BILLyTheLiTTle/RCCar_Engineering/README.md

# RCCar_Engineering
Everything for my experimental R/C car apart from source code.

The source code for the Android controller could be found here (https://github.com/BILLyTheLiTTle/RCController) and for the server on R/C car is here (https://github.com/BILLyTheLiTTle/RCCar).
