BILLyTheLiTTle/RCCar_Engineering/Parts/Mechanics/Mods/Standoffs/README.txt

== 10mm height standoff ==
- Rpi PowerRack

== 5mm height standoff ==
- Buck converters
- Perfboard / Veroboards
