BILLyTheLiTTle/RCCar_Engineering/Parts/Mechanics/Transmission System/3rd party design/Links.txt

The BTS7960 Housing was found here (https://www.thingiverse.com/thing:2589207/files) by b2vn.
