BILLyTheLiTTle/RCCar_Engineering/Designs/Mechanics/Differential/Description.pdf

## SOFTWARE DIFFERENTIAL FORMULAS

### Table of Contents

Introduction
During the implementation of my R/C Car I decided to design the formulas for the software differential. The R/C Car will have 4 motors, so the software differential is the only way. Apart from that, I believe that mechanical differentials:
- Cannot be improved further
- Cannot be smaller in size with the stiffness which a car needs
- Cannot be lighter (probably the can but they could be much more expensive)
- Cannot be eco-friendly (need fluids, power loss due to their moving parts and extra axles)
- Cannot take less space in the cabin (sometimes the place where you rest your hand is a camouflage for the axle that goes to the rear).

On the other side, electric motors just started to exist in automotive industry and probably they have more secrets to reveal! How about changing your car’s differential from open to locked in a single update? Now that I have your attention, we can continue!

Formulas
Symbols
Before starting the calculation, we have to say that we know the following:
- WL (wheel length distance, kingpin to kingpin),
- WW (wheel width distance, kingpin to kingpin),
- WR (wheel radius),
- TAwr & FAwr (outer front wheel turning angle),
- TAwf & FAwf (inner front wheel turning angle),
- Af (car turning angle).

The inner wheel formula should be equal to the real turning angle in order to achieve concentric circles.

The formulas for the Ackerman steering according to this (http://datagenetics.com/blog/december12016/index.html) (based on simple trigonometry of course, interior-exterior corresponding angles and triangle angles equality to 180 o
), are:
- | TAwf = ARif | (a)
- TAwr = ARof (b)
- | A’f = ARf | (c)

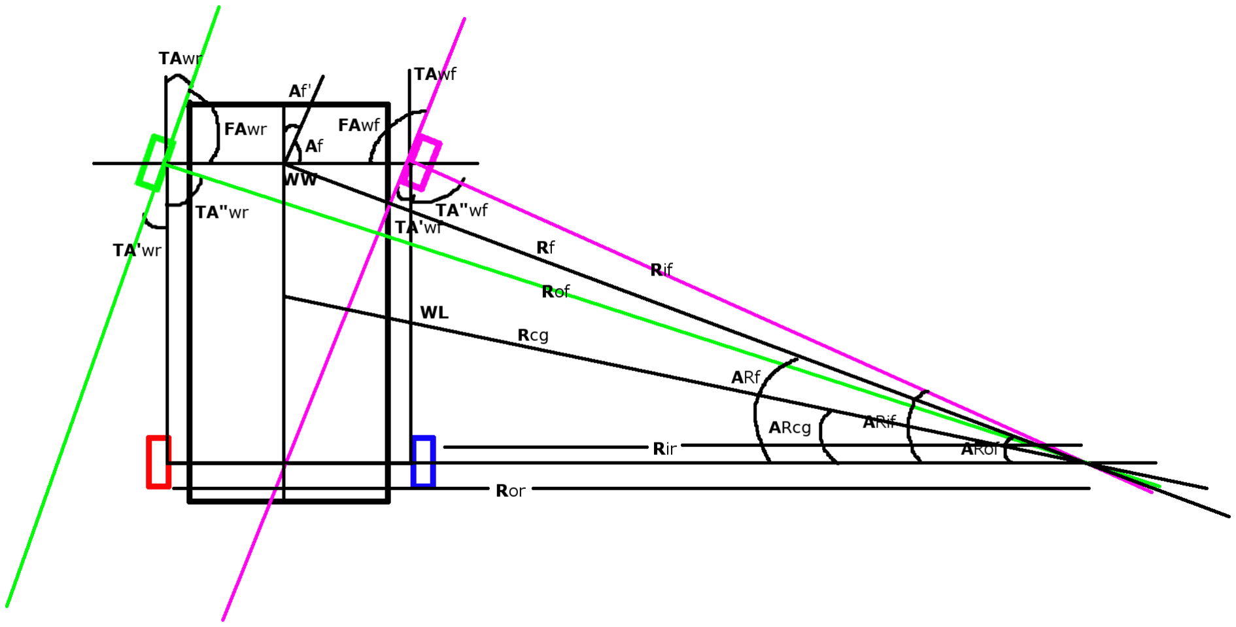
[picture p1: figure]

Prerequisite Formulas
Analyzing the angle equality, we have:

TA”wf + TA’wf = 90o => (TA’wf and TAwf angles are equal)

TA”wf + TAwf = 90o =>

TA”wf = 90 – TAwf (d)

And

TA’wr + TA”wr = 90o => (TA’wr and TAwr angles are equal)

TAwr + TA”wr = 90o =>

TA”wr = 90o – TAwr (e)

We could use inverse tangent because we know the angle:

TA”wf = tan⁻¹
(Rir / WL) => (due to (d))

(90 – TAwf) = tan⁻¹
(Rir / WL) (f)

And

TA”wr = tan⁻¹
(Ror / WL) => (due to (e))

(90o – TAwr) = tan⁻¹
(Ror / WL) (g)

Rear Inner Wheel
According to the formula (f) we have:

(90 – TAwf) = tan⁻¹
(Rir / WL) =>

(90 – TAwf) = arctan(Rir / WL) =>

tan(90 – TAwf) = tan(arctan(Rir / WL)) =>

tan(90o – TAwf) = Rir / WL =>

tan(90o – TAwf) * WL = Rir

Therefore, the rear inner wheel is moving into a circle with radius:

Rir = tan(90o – TAwf) * WL (h)

Rear Outer Wheel
Without further ado, we have:

Ror = WW + Rir

Therefore, the rear outer wheel is moving into a circle with radius:

Ror = WW + Rir (i)

Front Outer Wheel
Using the steering angles, we have:

sin(ARof) = WL / Rof =>

Rof = (WL / sin(ARof) ) => (due to (b))

Rof = (WL / sin(TAwr) )

Therefore, the front outer wheel is moving into a circle with radius:

Rof = (WL / sin(TAwr) ) (j)

Front Inner Wheel
Using the steering angles, we have:

sin(ARif) = WL / Rif =>

Rif = ( WL / sin(ARif) ) => (due to (a))

Rif = ( WL / sin(TAwf) )

Therefore, the front inner wheel is moving into a circle with radius:

Rif = ( WL / sin(TAwf) ) (k)

Center of the car
We are going to use also data about the car as an object. In true Ackerman we have every wheel moving in concentric circles, but in parallel and reverse steering the front wheels are moving in different circles. So, we must find out the circle in which the center of the car is moving.

Every point on the car is moving in concentric circles. This mean that the center of the front axle, the center of the car and the center of the rear axle are moving into concentric circles.

By having a device measuring the angle of the car (Af) we could calculate the Af angle.

Let’s define R’ir that it is the radius for the center of the circle to the inner rear wheel.

In true Ackerman steering we have Rir’ = Rir (l) because wheels and car are moving into concentric circles, but at the other two options (parallel, reverse) the car could be moving in non-concentric circle with the wheels. Even the wheels themselves are probably moving in non-concentric circles. Then we have:

tan(ARf) = WL / (R’ir + WW/2) => (due to (c))

tan(A’f) = WL / (R’ir + WW/2) =>

R’ir = (WL / tan(A’f)) – WW/2 (l’)

As said before, every point on the car is moving in concentric circles, so the chassis is not able to steer like the front wheels, so the whole car chassis is moving in concentric circles. This means that the straight lines Rf, Rcg are starting from the car chassis and they are ending in the same point (center of concentric circles).

Applying Pythagorean theorem and due to above explanation, we have:

(Rcg)

2 = (R’ir + WW/2)² + (WL/2)²

Continuing further from Pythagorean equation, for true Ackerman steering:

(Rcg)

2 = ( Rir’ + WW/2 )² + (WL / 2)² => (due to (l))

(Rcg)

2 = ( Rir + WW/2 )² + (WL / 2)²

Continuing further from Pythagorean equation, for parallel and reverse steering:

(Rcg)

2 = ( Rir’ + WW/2 )² + (WL / 2)² => (due to (l’))

Rcg = SQRT ( ( (WL / tan(Af

’

) ) - WW/2 + WW/2 )² + (WL / 2)² ) =>

Rcg = SQRT ( ( (WL / tan(Af

’

) ) )² + (WL / 2)²
)

The formulas should be:

True Ackerman Steering formula: Rcg = SQRT ((Rir + WW/2)² + (WL / 2)² ) (m)

Parallel, Reverse Steering Formula Rcg = SQRT ( ( (WL / tan(Af

’

) ) )² + (WL / 2)²
) (m’)

Wheel Rotations
The front outer wheel will travel the longest distance of all four wheels. Our calculations will be based on this wheel because if the driver is in 100% throttle, we cannot make a motor to work at more than 100%. So, the we apply the throttle to the outer front wheel (instead of a motor in simple Evs, or combustion engine on fossil fuel cars).

On the other side, if the outer wheel is not moving, we could apply 0 power, or negative (in a future implementation…probably!).

From paper “Electronic Differential System for an Electric Vehicle with In-Wheel Motor” (https://ieeexplore.ieee.org/document/7394567) we have the following formulas for Estimated Rotations (ER):

ERof = Wof = V x Rof / (Rcg x WR) (n)

ERif = Wif = V x Rif / (Rcg x WR) (o)

ERor = Wor = V x Ror / (Rcg x WR) (p)

ERir = Wir = V x Rir / (Rcg x WR) (q)

for open differential. For locked differential just apply the same rotation (not PWM value) value to each wheel. For in-between values just pick some values in-between!

For example:

- Open Differential -> Outer front wheel will have max rotations and the others according to the previous calculations
- Semi-open Differential Front -> Outer front wheel will have max rotations and the opposing wheel will have an in-between (from open to locked) value
- Semi-open Differential Rear -> Outer rear wheel will have max rotations (as max as possible in relation with the outer front wheel) and the opposing wheel will have an in-between (from open to locked) value
- Locked Differential -> Apply everywhere the same rotations

Predefined Table Example
We could use a predefined table in order to apply a close-to-correct PWM value faster. This is an example and should not be used as-is neither in the real world scenario nor in this document!
PWM value (% throttle value) | Rotations @ wheel (per second)
Front Left | Front Right | Rear Left | Rear Right
50 (19.61%) | 5 | 6 | 5 | 4
100 (39.21%) | 12 | 14 | 16 | 11
150 (58.82%) | 22 | 22 | 18 | 25
190 (74.51%) | 44 | 43 | 45 | 48
220 (86.27%) | 50 | 49 | 47 | 53
255 (100%) | 56 | 57 | 57 | 55

Vehicle Dynamics
Imagine that you could apply more throttle in the wheel which have more traction…

Later…

Use case (Ackerman scenario) For a car during a single right turn we have the input:

WL = 4m, WW = 1.5m, TAwr = 19o

, TAwf = 21.5o
, Af

’ = 20.15o
, 195/50R15,

throttle = 50%

and according to the previous equations we have:

(h) => Rir = tan(90 – TAwf) * WL = tan (90o – 21.5

o
) * 4 = 10.155m
(i) => Ror = WW + Rir = 1.5 + 10.154 = 11.655m
(j) => Rof = (WL / sin(TAwr) ) = 4 / sin(19o
) = 12.286m
(k) => Rif = ( WL / sin(TAwf) ) = 4 / sin(21.5o
) = 10.914m

And the rim calculations are:

RimRadius = (15 * 0.0254) / 2 = 0.1905m

TyreProfile = (0.195 * 0.5) = 0.0975m

WR = RimRadius + TyreProfile = 0.1905 + 0.0975 = 0.288m

Calculating the wheel rotations, we have:

For throttle = 50%, we have 127.5 of 255 PWM value, so we apply this PWM to outer front wheel and calculate its rotations by a speed sensor. Let’s say we have measured 17 rotations per second.

Parallel, reverse | Ackerman only
(m’) => Rcg = SQRT ( ( (WL / tan(Af ’ ) ) )² + (WL / 2)² ) => Rcg = SQRT ( ( (4 / tan(20.15) ) ) 2 + (4 / 2)² ) => 2 + 4) => Rcg = SQRT ( (10.901) Rcg = 11.083m | (m) => Rcg = SQRT ( (Rir + WW/2)² + (WL / 2)² ) => Rcg = SQRT( (10.155 + 0.75) 2 + (4/2) 2 ) => Rcg = 11.087m
(n) => Wof = V x Rof / Rcg x WR => 17 = V * 12.286 / 11.083 * 0.288 => 17 = V * 12.286 / 3.191904 => | (n) => Wof = V x Rof / Rcg x WR => 17 = V * 12.286 / 11.087 * 0.288 => 17 = V * 12.286 / 3.193056 =>

V = 17 * 3.191904 / 12.286 => V = 4.417 m/s | V = 17 * 3.193056 / 12.286 => V = 4.418 m/s
(o) => Wif = V x Rif / (Rcg x WR) => Wif = 4.417 * 10.914 / 11.083 * 0.288 => Wif = 15.103 rps | (o) => Wif = V x Rif / (Rcg x WR) => Wif = 4.418 * 10.914 / 11.087 * 0.288 => Wif = 15.101 rps
(p) => Wor = V x Ror / (Rcg x WR) => Wor = 4.417 * 11.655 / 11.083 * 0.288 => Wor = 16.12 rps | (p) => Wor = V x Ror / (Rcg x WR) => Wor = 4.418 * 11.655 / 11.087 * 0.288 => Wor = 16.126 rps
(q) => Wir = V x Rir / (Rcg x WR) => Wir = 4.417 * 10.155 / 11.083 * 0.288 => Wir = 14.053 rps | (q) => Wir = V x Rir / (Rcg x WR) => Wir = 4.418 * 10.155 / 11.087 * 0.288 => Wir = 14.051 rps
WFrontLeft = 17rps WFrontRight = 15.103 rps WrearLeft = 16.12 rps WrearRight = 14.053 rps | WFrontLeft = 17rps WFrontRight = 15.101 rps WrearLeft = 16.126 rps WrearRight = 14.051 rps

Flowchart
This flowchart is in early stage; so:
- It is not describing an algorithm in actual code,
- It needs an algorithm to calculate the PWM value for specified rotations,
- It has some restrictions (such as the differential settings could be applied when car is not moving).
- It cannot calculate ranges 29.5o

in a turning wheel is different from 29.6o .
This should not happen, at least in small speeds!
- It lacks hardware features (such us interruption) because I still don’t have a lot of experience on these. Programmed I/O is a good start, though!
- I have not decided if this software will work on a controller or on a OS using threads.

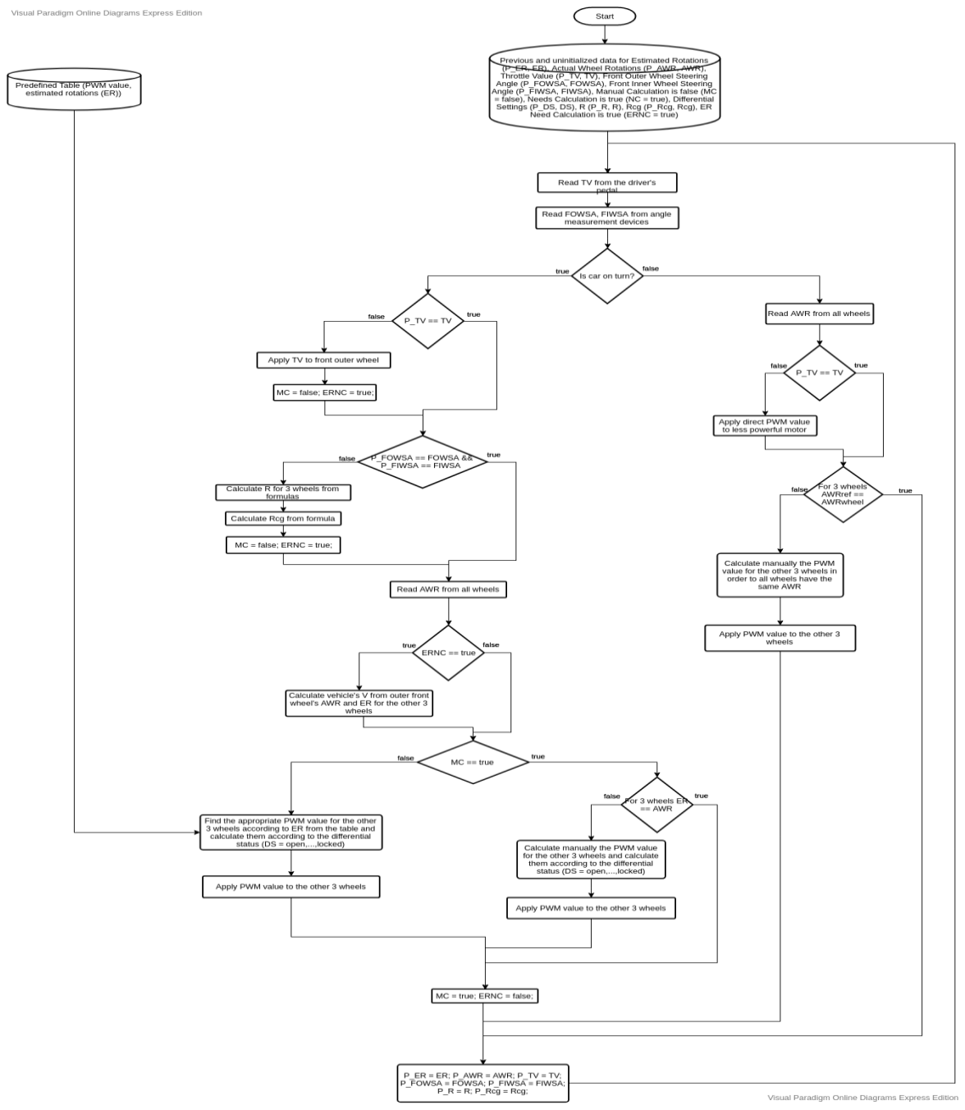
[picture p2: figure]
