BILLyTheLiTTle/RCCar_Engineering/Designs/Electronics/GPIOs data.xlsx

Sheet: Draft
GPIO No | BCM No | Alt Functions |  | Current (mA) | Usage
GPIO 8 | BCM 2 | I2C1 - SDA |  |  | I2C Multiplexer with sensors
GPIO 9 | BCM 3 | I2C1 - SCL
GPIO 4 | BCM 23 |  |  |  | Shift Register for LEDs
GPIO 5 | BCM 24
GPIO 6 | BCM 25
GPIO 25 | BCM 26 |  |  |  | Control the servo motor (steering wheel)
GPIO 12 | BCM 10 | SPI0 - MOSI |  |  | Shared use between SPI devices
 |  |  |  |  | CE1: MCP3208 slave
 |  |  |  |  | CE0: MCP23S17 slaves
 |  |  |  |  | 1. GPA0: DIR for motor front left
 |  |  |  |  | 2. GPA1: DIR for motor front right
 |  |  |  |  | 3. GPA2: DIR for motor rear left
 |  |  |  |  | 4. GPA3: DIR for motor rear right
 |  |  |  |  | 5. GPA4: Rear right wheel speed sensor
 |  |  |  |  | 6. GPA5: Rear left wheel speed sensor
 |  |  |  |  | 7. GPA6: Front right wheel speed sensor
 |  |  |  |  | 8. GPA7: Front left wheel speed sensor
 |  |  |  |  | 9. GPB0: 74HC4051 (0) - A
 |  |  |  |  | 10. GPB1: 74HC4051 (0) - B
 |  |  |  |  | 11. GPB2: 74HC4051 (0) - C
 |  |  |  |  | 12. GPB3: 74HC4051 (1) - A
GPIO 13 | BCM 9 | SPI0 - MISO |  |  | 13. GPB4: 74HC4051 (1) - B
GPIO 14 | BCM 11 | SPI0 - CLK |  |  | 14. GPB5: 74HC4051 (1) - C
GPIO 10 | BCM 8 | SPI0 - CE0 |  |  | 15. GPB6: BASE transistor left turn light blink
GPIO 11 | BCM 7 | SPI0 - CE1 |  |  | 16. GPB7: BASE transistor right turn light blink
GPIO 28 | BCM 20 | SPI1 - MOSI
GPIO 29 | BCM 21 | SPI1 - SCLK
GPIO 23 | BCM 13 | PWM1 |  |  | Motor Front Right
GPIO 24 | BCM 19 | PWM1 | SPI1 - MISO |  | Motor Front Left
GPIO 1 | BCM 18 | PWM0 | SPI1 - CE0 |  | Motor Rear Left
GPIO 26 | BCM 12 | PWM0 |  |  | Motor Rear Right
GPIO 15 | BCM 14 | UART0 - TXD
GPIO 16 | BCM 15 | UART0 - RXD
GPIO 7 | BCM 4 | GPCLK0 |  |  | Shift Register for Solenoids?
GPIO 21 | BCM 5 | GPCLK1 |  |  | Nope. Better use another one MCP23S17
GPIO 22 | BCM 6 | GPCLK2
GPIO 27 | BCM 16 | SPI1 - CE2
GPIO 0 | BCM 17 | SPI1 - CE1
GPIO 2 | BCM 27
GPIO 3 | BCM 22

Sheet: Raspberry Pi
GPIO No | BCM No | Alt Functions |  | Logic Current (mA) | Min Load Current (mA) | Max Load Current (mA) | Usage
GPIO 8 | BCM 2 | I2C1 - SDA
GPIO 9 | BCM 3 | I2C1 - SCL
GPIO 4 | BCM 23 |  |  | 0.59567 | 500 – 900 @6V | 2500 @6V stall | Servo Motor (steering wheel)
GPIO 5 | BCM 24
GPIO 6 | BCM 25
GPIO 25 | BCM 26
GPIO 12 | BCM 10 | SPI0 - MOSI |  |  |  |  | MCP23S17(IC0, IC1) SI Pin
GPIO 13 | BCM 9 | SPI0 - MISO |  |  |  |  | MCP23S17(IC0, IC1) SO Pin
GPIO 14 | BCM 11 | SPI0 - CLK |  |  |  |  | MCP23S17(IC0, IC1) SCK Pin
GPIO 10 | BCM 8 | SPI0 - CE0 |  |  |  |  | MCP23S17(IC0, IC1) CS Pin
GPIO 11 | BCM 7 | SPI0 - CE1
GPIO 28 | BCM 20 | SPI1 - MOSI
GPIO 29 | BCM 21 | SPI1 - SCLK
GPIO 23 | BCM 13 | PWM1 |  |  |  |  | To 1Z pin of 74HC4053(IC0) for Front Left Motor
GPIO 24 | BCM 19 | PWM1 | SPI1 - MISO |  |  |  | To 2Z pin of 74HC4053(IC0) for Front Right Motor
GPIO 1 | BCM 18 | PWM0 | SPI1 - CE0 |  |  |  | To 1Z pin of 74HC4053(IC1) for Rear Left Motor
GPIO 26 | BCM 12 | PWM0 |  |  |  |  | To 2Z pin of 74HC4053(IC1) for Rear Right Motor
GPIO 15 | BCM 14 | UART0 - TXD
GPIO 16 | BCM 15 | UART0 - RXD
GPIO 7 | BCM 4 | GPCLK0
GPIO 21 | BCM 5 | GPCLK1
GPIO 22 | BCM 6 | GPCLK2
GPIO 27 | BCM 16 | SPI1 - CE2
GPIO 0 | BCM 17 | SPI1 - CE1
GPIO 2 | BCM 27
GPIO 3 | BCM 22
 |  |  |  | 0.59567

Sheet: MCP23S17(IC0)
Pin id | Current (mA) | Usage
GPA 0 |  | Pin S1 of 74HC4053(IC0)
GPA 1 |  | Pin S2 of 74HC4053(IC0)
GPA 2 |  | Pin S3 of 74HC4053(IC0)
GPA 3 |  | Pins R_EN & L_EN of BTS7960(IC0)
GPA 4 |  | Pins R_EN & L_EN of BTS7960(IC1)
GPA 5
GPA 6
GPA 7
GPB 0 |  | Pin S1 of 74HC4053(IC1)
GPB 1 |  | Pin S2 of 74HC4053(IC1)
GPB 2 |  | Pin S3 of 74HC4053(IC1)
GPB 3 |  | Pins R_EN & L_EN of BTS7960(IC2)
GPB 4 |  | Pins R_EN & L_EN of BTS7960(IC3)
GPB 5
GPB 6
GPB 7
SI |  | GPIO 12 / BCM 10
SO |  | GPIO 13 / BCM 9
SCK |  | GPIO 14 / BCM 11
CS |  | GPIO 10 / BCM 8

Sheet: MCP23S17(IC1)
Pin id | Current (mA) | Usage
GPA 0 |  | Pin Input1 of L293D(IC0)
GPA 1 |  | Pin Input2 of L293D(IC0)
GPA 2
GPA 3
GPA 4
GPA 5
GPA 6
GPA 7
GPB 0
GPB 1
GPB 2
GPB 3
GPB 4
GPB 5
GPB 6
GPB 7
SI |  | GPIO 12 / BCM 10
SO |  | GPIO 13 / BCM 9
SCK |  | GPIO 14 / BCM 11
CS |  | GPIO 10 / BCM 8

Sheet: 74HC4053(IC0)
Pin id | Current (mA) | Usage
S1 |  | MCP23S17(IC0) Pin GPA 0
S2 |  | MCP23S17(IC0) Pin GPA 1
S3 |  | MCP23S17(IC0) Pin GPA 2
1Y0 |  | BTS7960(0) Pin RPWM
2Y0 |  | BTS7960(1) Pin RPWM
3Y0
1Y1 |  | BTS7960(0) Pin LPWM
2Y1 |  | BTS7960(1) Pin LPWM
3Y1
1Z |  | GPIO 23 / BCM 13
2Z |  | GPIO 24 / BCM 19
3Z

Sheet: 74HC4053(IC1)
Pin id | Current (mA) | Usage
S1 |  | MCP23S17(IC0) Pin GPB 0
S2 |  | MCP23S17(IC0) Pin GPB 1
S3 |  | MCP23S17(IC0) Pin GPB 2
1Y0 |  | BTS7960(2) Pin RPWM
2Y0 |  | BTS7960(3) Pin RPWM
3Y0
1Y1 |  | BTS7960(2) Pin LPWM
2Y1 |  | BTS7960(3) Pin LPWM
3Y1
1Z |  | GPIO 1 / BCM 18
2Z |  | GPIO 26 / BCM 12
3Z
