BILLyTheLiTTle/RCCar_Engineering/Designs/Electronics/1. Power System/Buck Converters.png

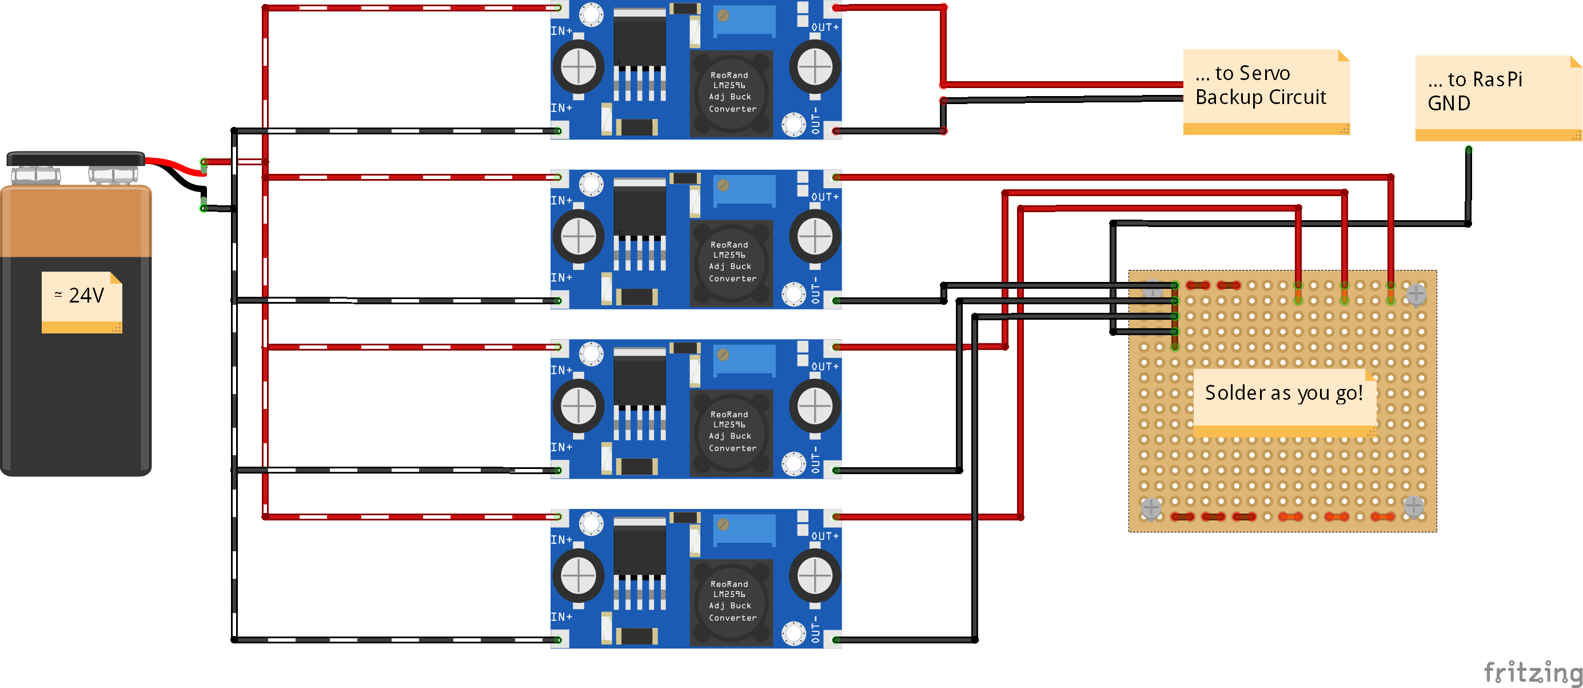
Designs/Electronics/1. Power System/Buck Converters.png
