BILLyTheLiTTle/RCCar_Engineering/Designs/Electronics/2. Steering System/Breadboard/Servo Controller.png

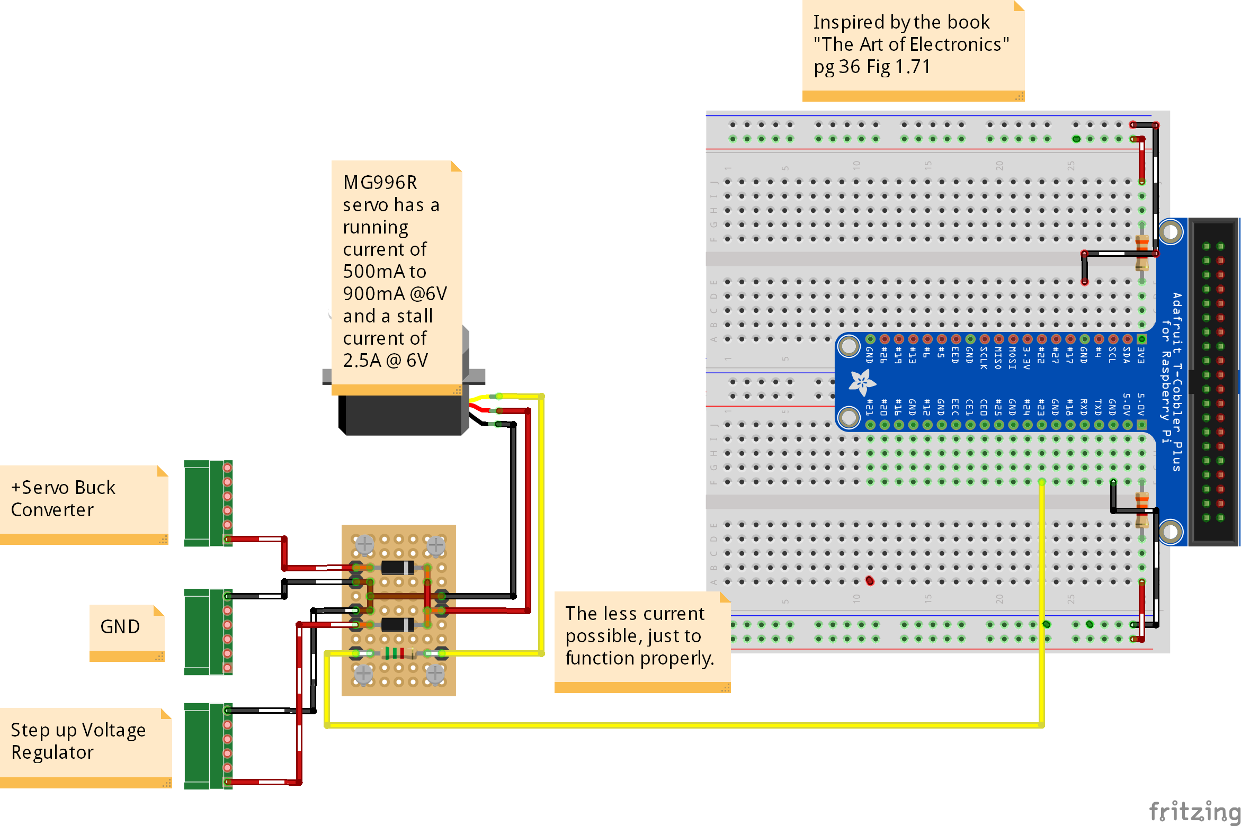
Designs/Electronics/2. Steering System/Breadboard/Servo Controller.png
