BILLyTheLiTTle/RCCar_Engineering/Designs/Electronics/2. Steering System/Perfboard/Servo Controller.png

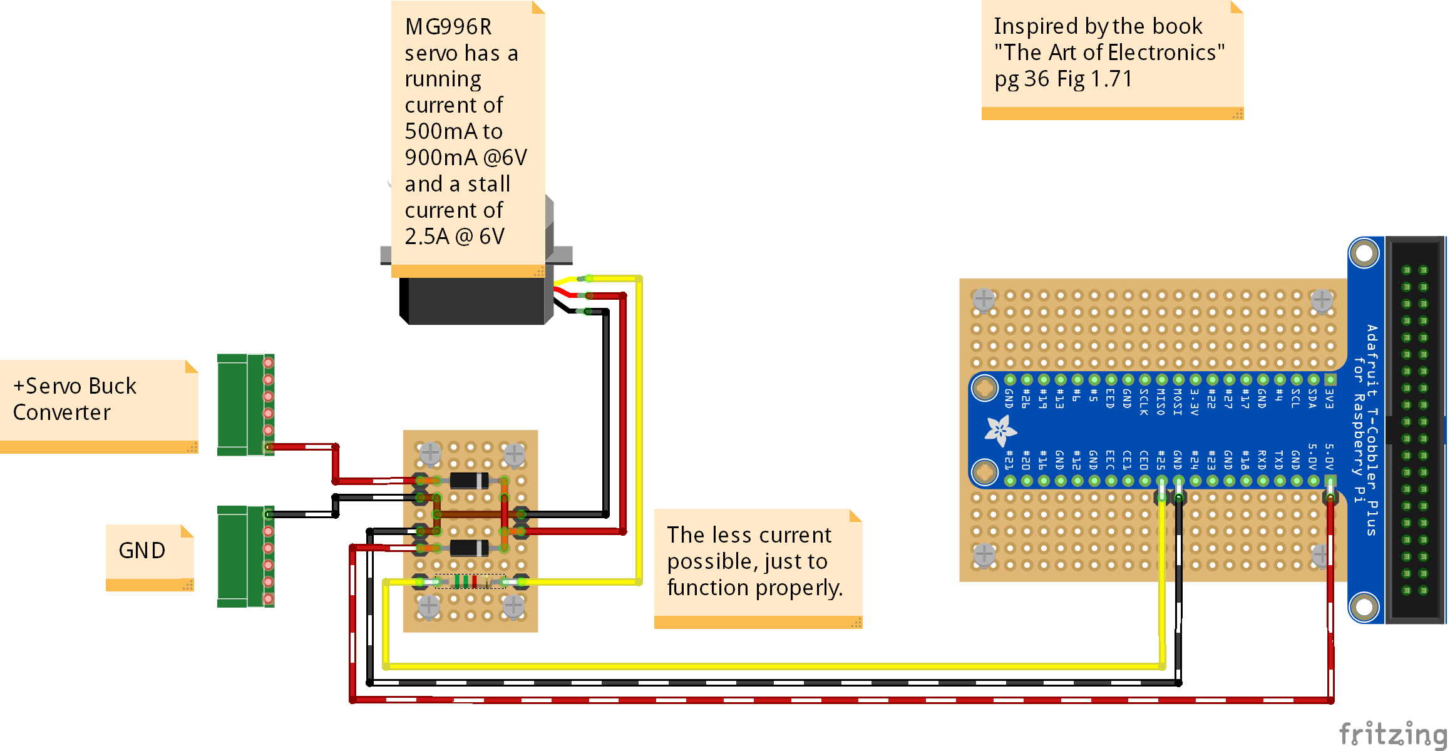
Designs/Electronics/2. Steering System/Perfboard/Servo Controller.png
