BILLyTheLiTTle/RCCar_Engineering/Designs/Electronics/3. Transmission System/Breadboard/BTS7960 Connection System.png

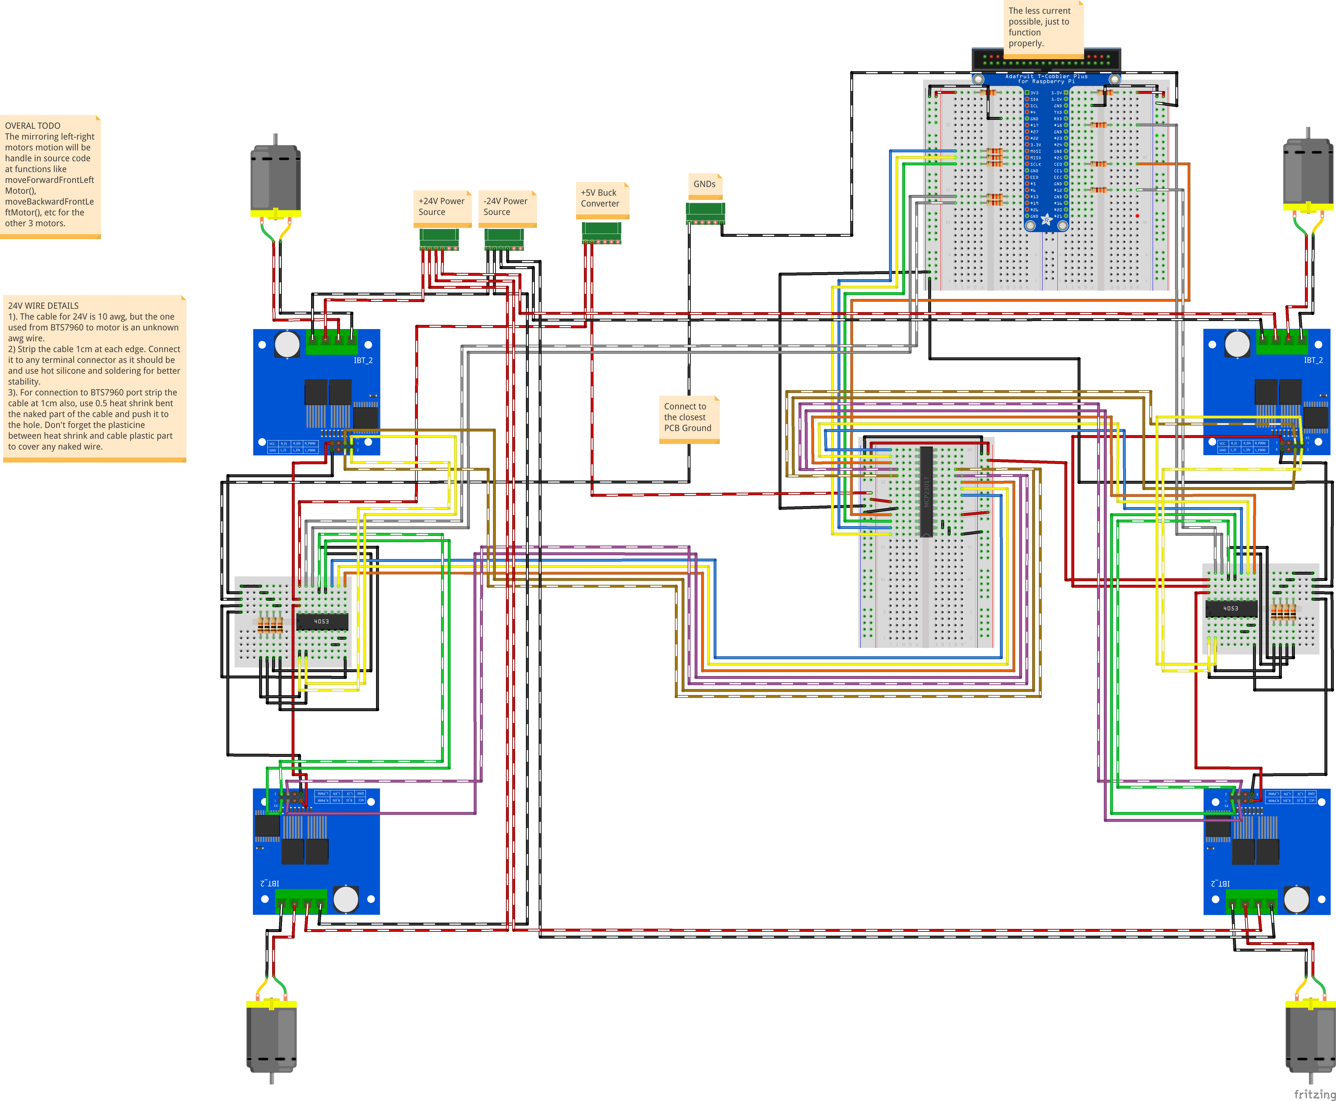
Designs/Electronics/3. Transmission System/Breadboard/BTS7960 Connection System.png
