BILLyTheLiTTle/RCCar_Engineering/Designs/Electronics/4. Cooling System/Breadboard/Water Cooling Conection System.png

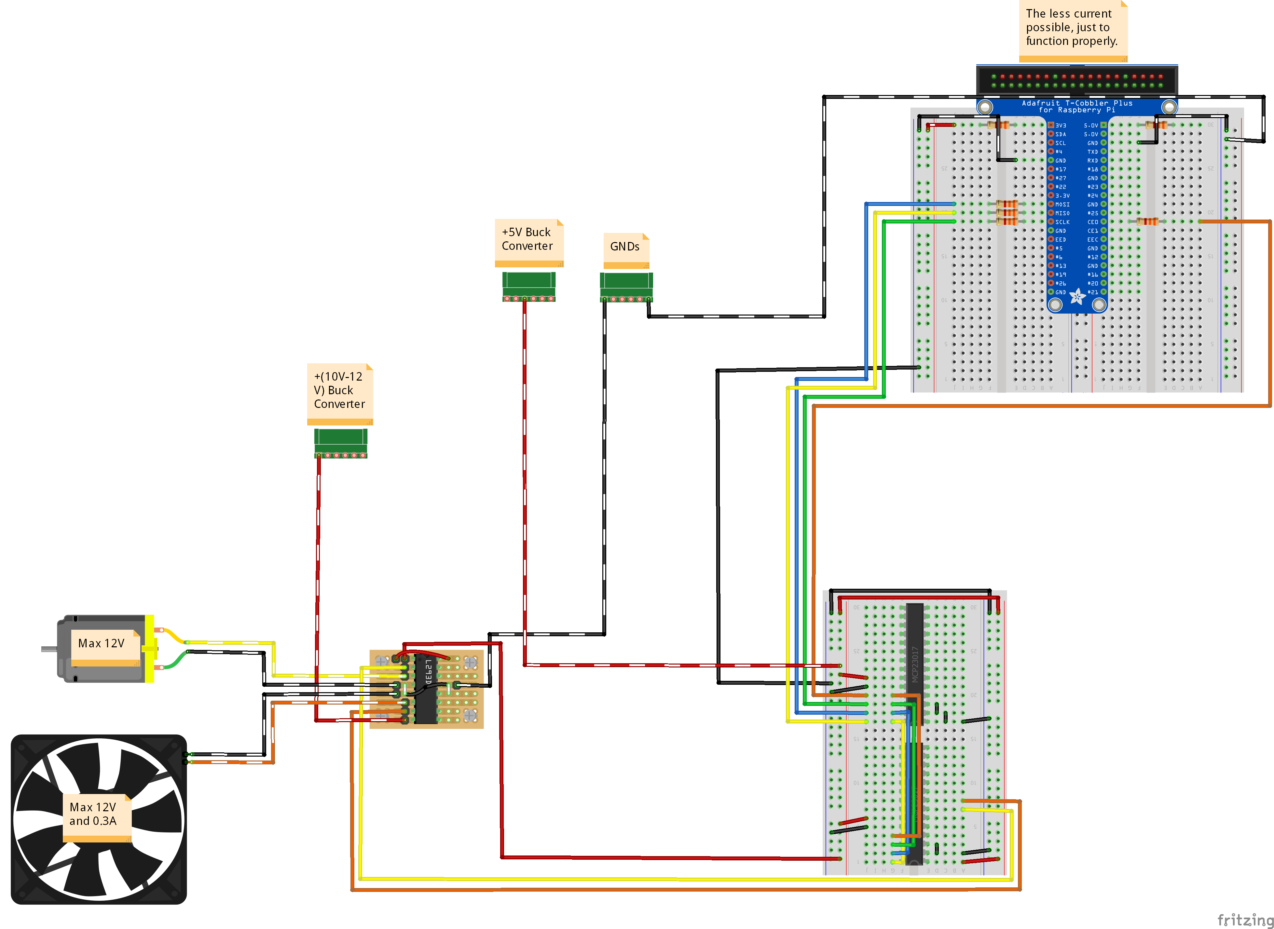
Designs/Electronics/4. Cooling System/Breadboard/Water Cooling Conection System.png
