BILLyTheLiTTle/RCCar_Engineering/Designs/Electronics/4. Cooling System/Perfboard/Water Cooling Conection System.png

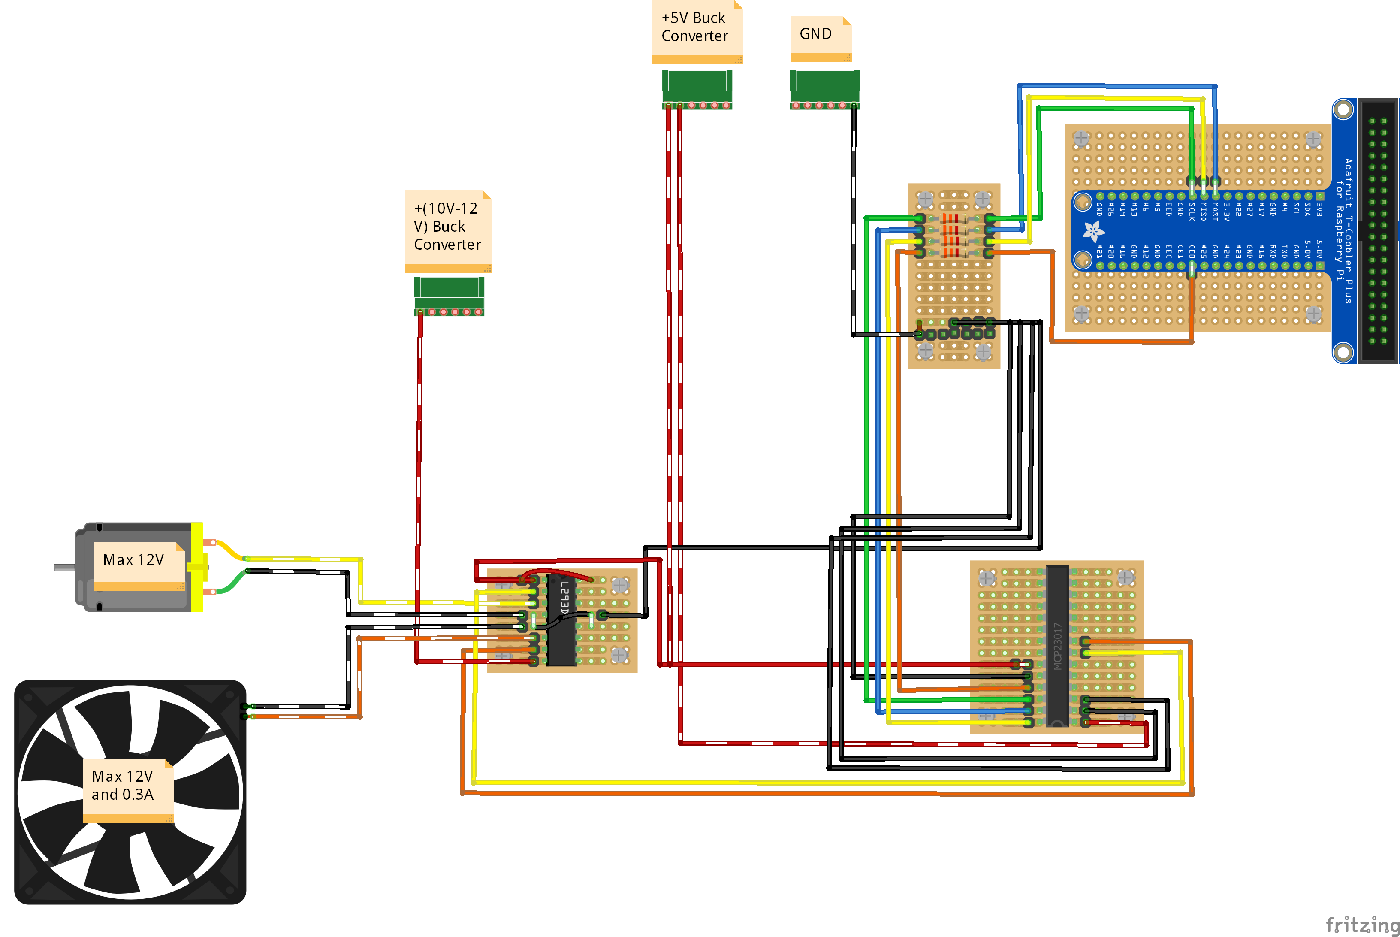
Designs/Electronics/4. Cooling System/Perfboard/Water Cooling Conection System.png
