BILLyTheLiTTle/RCCar_Engineering/Designs/Electronics/4. Cooling System/Parts/README.txt

- Fan-Ventilador part could be found here: https://forum.fritzing.org/t/fan-ventilador-5v-download-piece/2096
