BILLyTheLiTTle/RCCar_Engineering/Designs/Electronics/Parts/README.txt

- Adafruit T-Cobbler Plus part could be found here: https://github.com/adafruit/Fritzing-Library/blob/master/parts/Adafruit%20T-Cobbler%20Plus.fzpz
