BILLyTheLiTTle/RCCar_Engineering/Mechanics/Steering System/Rack -n- Pinion Tests/Secondary Pinion.stl

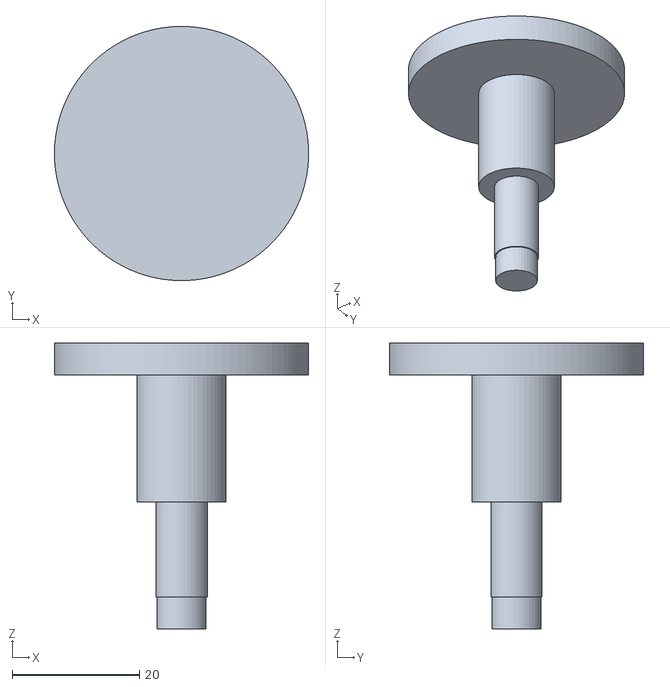
[picture p10: CAD file, 2019-10-02]
Mechanics/Steering System/Rack -n- Pinion Tests/Secondary Pinion.stl
40.0 x 40.0 x 45.0
