BILLyTheLiTTle/RCCar_Engineering/Parts/Mechanics/Mods/Floors/Perfboard Rpi Expander Floor.stl

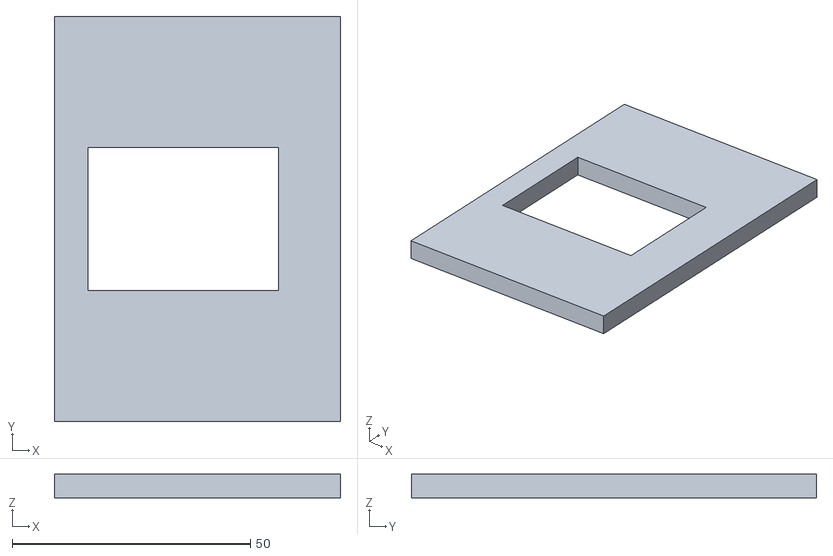
[picture p11: CAD file, 2019-12-09]
Parts/Mechanics/Mods/Floors/Perfboard Rpi Expander Floor.stl
60.0 x 85.0 x 5.00
