BILLyTheLiTTle/RCCar_Engineering/Parts/Mechanics/Mods/Motor Cup Stop.stl

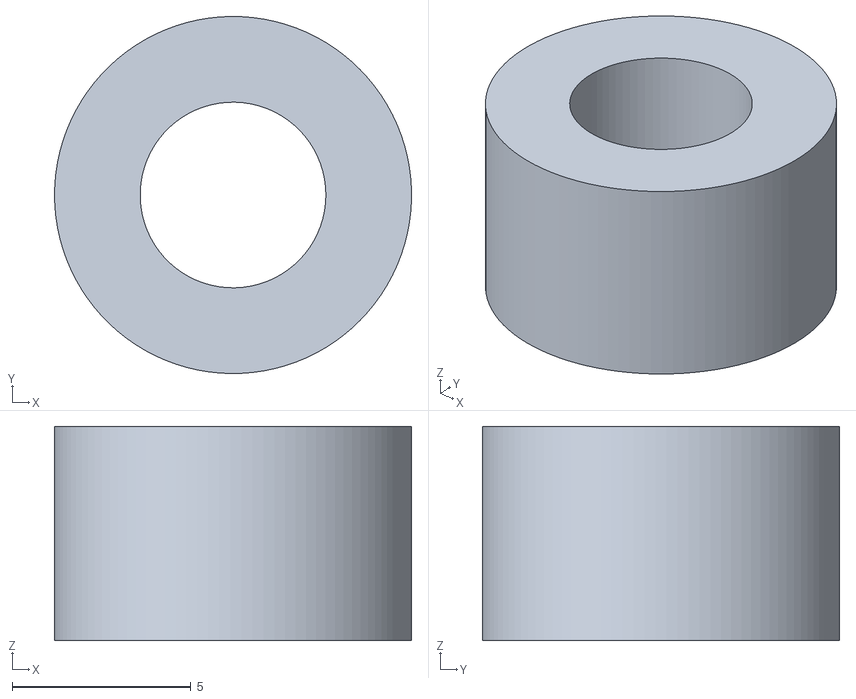
[picture p12: CAD file, 2019-08-29]
Parts/Mechanics/Mods/Motor Cup Stop.stl
10.00 x 10.00 x 6.00
