BILLyTheLiTTle/RCCar_Engineering/Parts/Mechanics/Mods/Standoffs/5mm height.stl

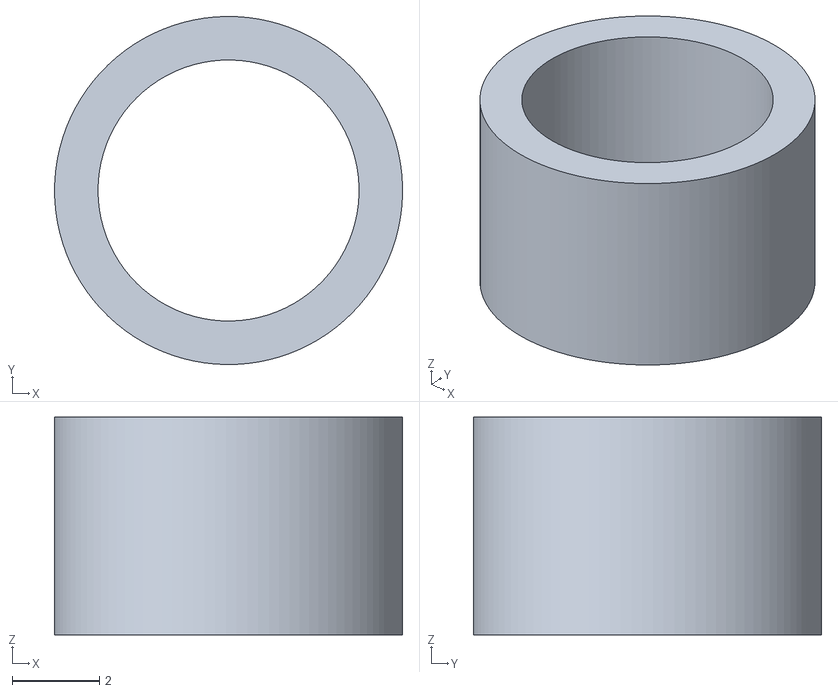
[picture p13: CAD file, 2019-11-12]
Parts/Mechanics/Mods/Standoffs/5mm height.stl
8.00 x 8.00 x 5.00
