BILLyTheLiTTle/RCCar_Engineering/Parts/Mechanics/Steering System/Rack -n- Pinion/Zahnstange_und_ritzel.stl

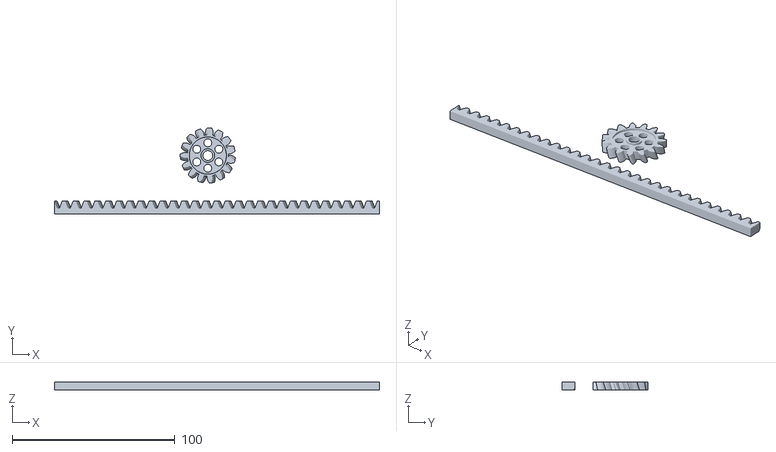
[picture p14: CAD file, 2019-10-02]
Parts/Mechanics/Steering System/Rack -n- Pinion/Zahnstange_und_ritzel.stl
200.0 x 53.0 x 5.00
