BILLyTheLiTTle/RCCar_Engineering/Parts/Mechanics/Steering System/Rack Wedge.stl

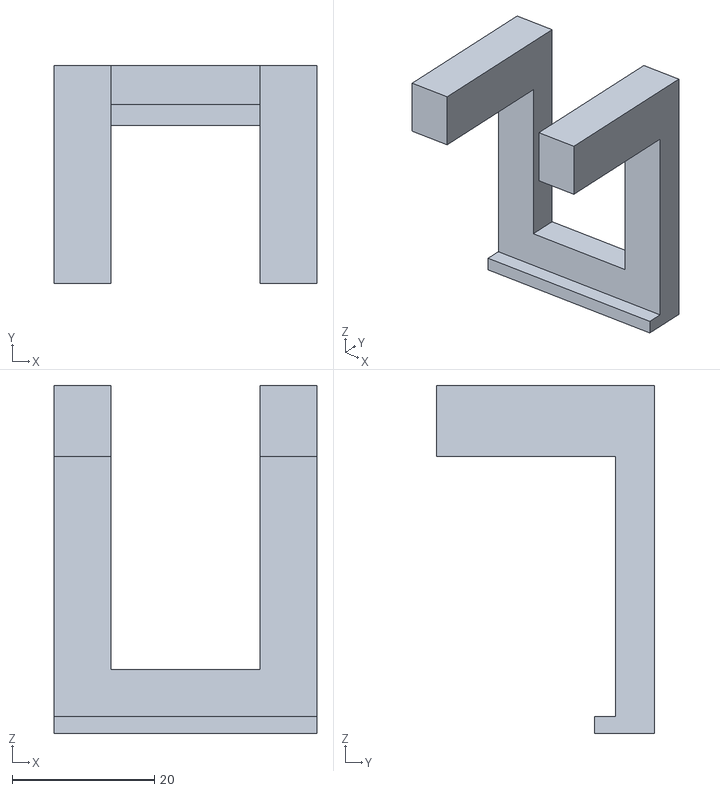
[picture p15: CAD file, 2019-10-04]
Parts/Mechanics/Steering System/Rack Wedge.stl
37.0 x 30.8 x 49.0
