BILLyTheLiTTle/RCCar_Engineering/Parts/Mechanics/Suspension System/Arm Chassis Dowel Pin.stl

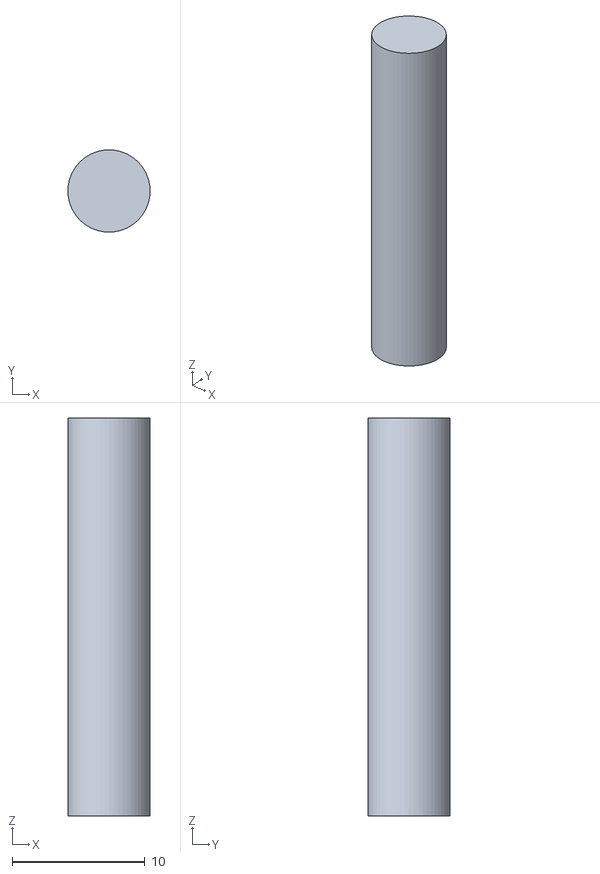
[picture p16: CAD file, 2019-08-02]
Parts/Mechanics/Suspension System/Arm Chassis Dowel Pin.stl
6.20 x 6.20 x 30.0
