BILLyTheLiTTle/RCCar_Engineering/Parts/Mechanics/Suspension System/Front/Front Arms.stl

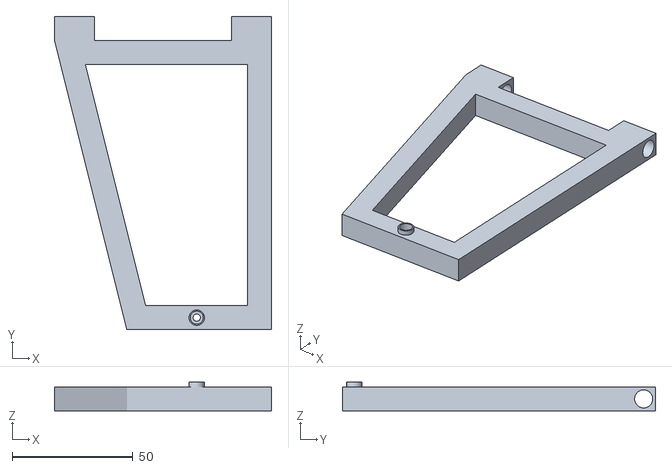
[picture p17: CAD file, 2019-09-23]
Parts/Mechanics/Suspension System/Front/Front Arms.stl
90.0 x 130.0 x 12.0
