BILLyTheLiTTle/RCCar_Engineering/Parts/Mechanics/Suspension System/Front/Tests/Bearing Arm hole.stl

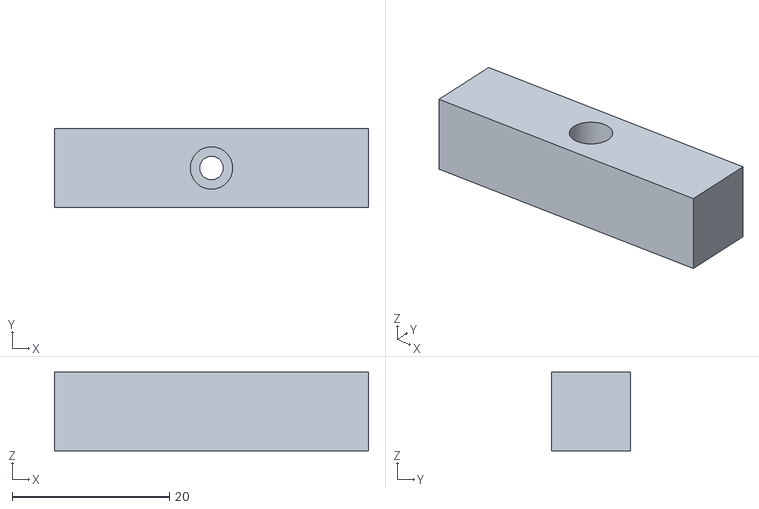
[picture p18: CAD file, 2019-09-23]
Parts/Mechanics/Suspension System/Front/Tests/Bearing Arm hole.stl
40.0 x 10.0 x 10.0
