BILLyTheLiTTle/RCCar_Engineering/Parts/Mechanics/Suspension System/Rear/Rear Arm Wheel Dowel Stop.stl

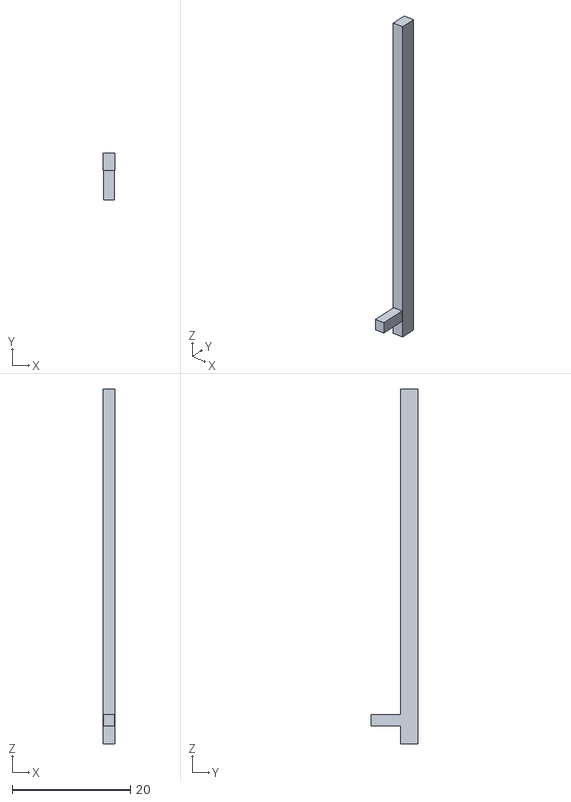
[picture p19: CAD file, 2019-08-29]
Parts/Mechanics/Suspension System/Rear/Rear Arm Wheel Dowel Stop.stl
2.00 x 8.00 x 60.0
