BILLyTheLiTTle/RCCar_Engineering/Parts/Mechanics/Transmission System/3rd party design/BTS7960 Housing Stands.stl

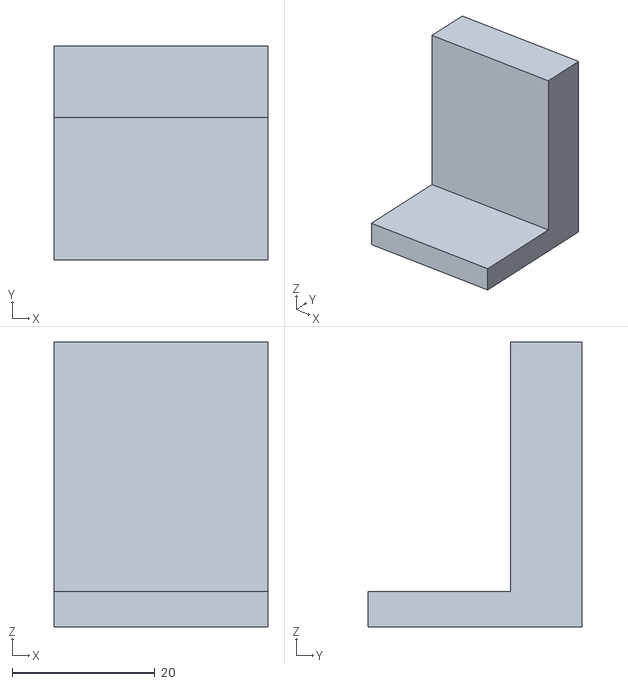
[picture p20: CAD file, 2020-02-27]
Parts/Mechanics/Transmission System/3rd party design/BTS7960 Housing Stands.stl
30.0 x 30.0 x 40.0
