BILLyTheLiTTle/RCCar_Engineering/Parts/Mechanics/Transmission System/BTS7960 Housing.stl

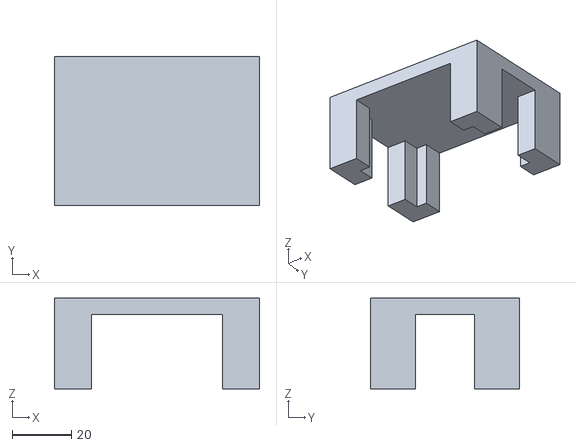
[picture p21: CAD file, 2019-12-20]
Parts/Mechanics/Transmission System/BTS7960 Housing.stl
69.0 x 50.0 x 30.5
