BILLyTheLiTTle/RCCar_Engineering/Parts/Mechanics/Wheels/Front/Front Right Dogbone.stl

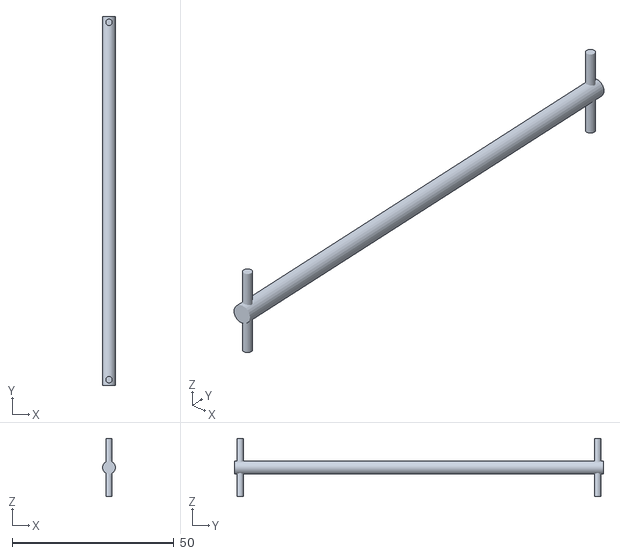
[picture p22: CAD file, 2019-10-02]
Parts/Mechanics/Wheels/Front/Front Right Dogbone.stl
4.00 x 114.0 x 18.0
