BILLyTheLiTTle/RCCar_Engineering/Parts/Mechanics/Wheels/Tests/Wheel Cup.stl

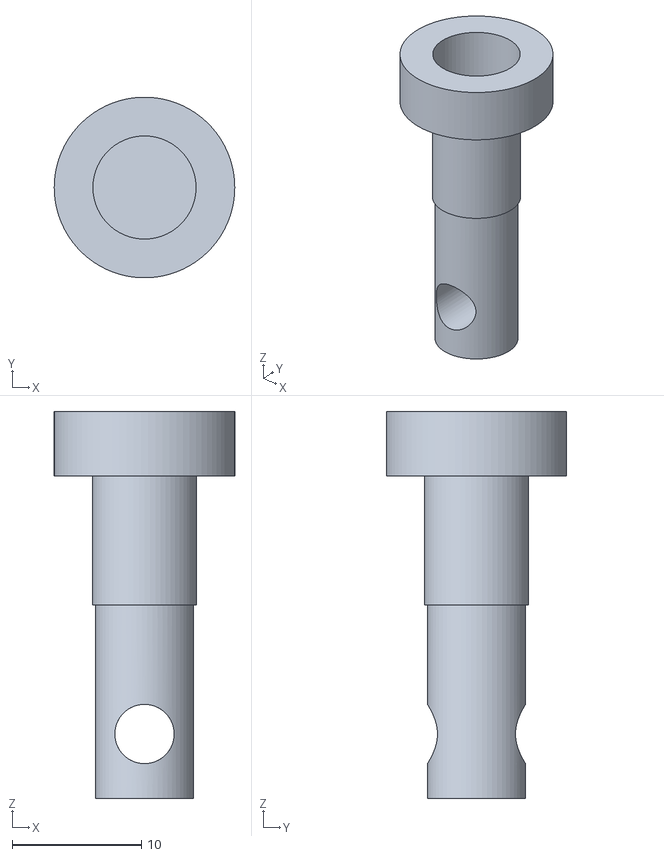
[picture p23: CAD file, 2019-09-30]
Parts/Mechanics/Wheels/Tests/Wheel Cup.stl
14.0 x 14.0 x 30.0
