BILLyTheLiTTle/RCCar_Engineering/Parts/Mechanics/Wheels/Wheel Cup.stl

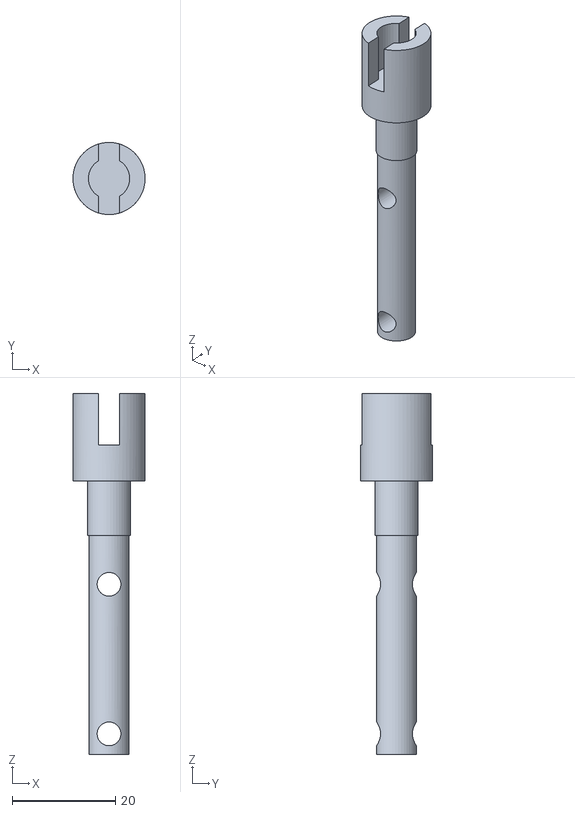
[picture p24: CAD file, 2019-10-01]
Parts/Mechanics/Wheels/Wheel Cup.stl
14.0 x 14.0 x 70.0
