BILLyTheLiTTle/RCCar_Engineering/Tools/Veroboard Drill Handler.stl

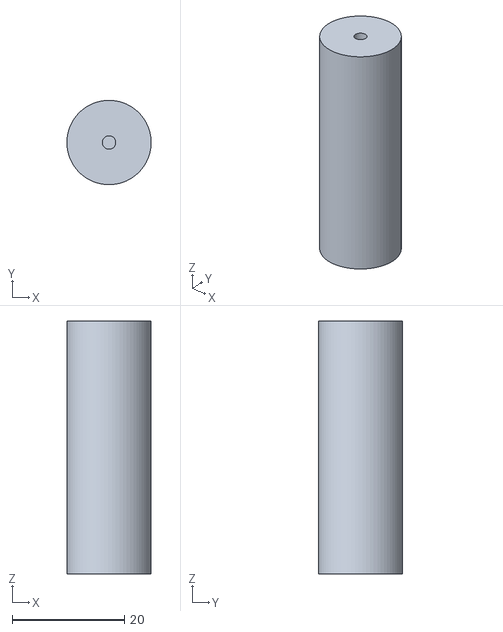
[picture p25: CAD file, 2019-12-09]
Tools/Veroboard Drill Handler.stl
15.0 x 15.0 x 45.0
