BILLyTheLiTTle/RCCar_Engineering/Mechanics/Steering System/Rack -n- Pinion Tests/Left Rack n Rod Connector.stl

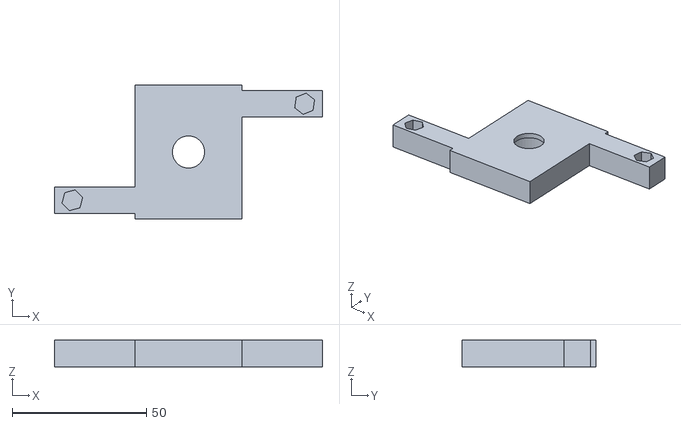
[picture p26: CAD file, 2019-10-01]
Mechanics/Steering System/Rack -n- Pinion Tests/Left Rack n Rod Connector.stl
100.0 x 50.0 x 10.0
