BILLyTheLiTTle/RCCar_Engineering/Parts/Mechanics/Mods/Floors/Buck Converters Floor.stl

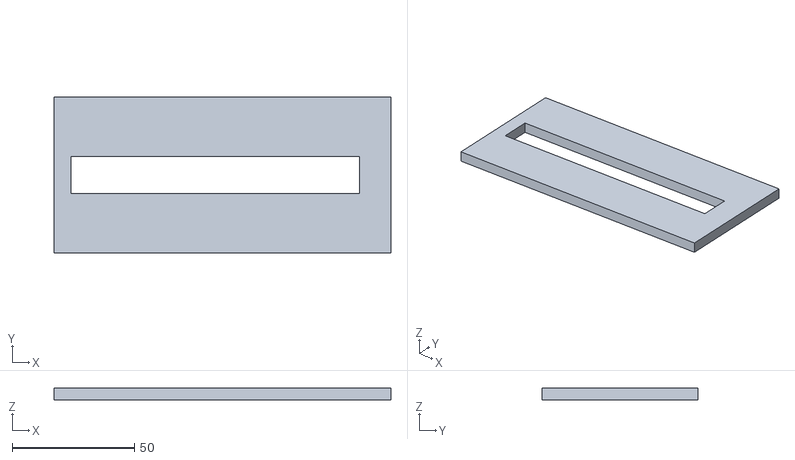
[picture p27: CAD file, 2019-12-05]
Parts/Mechanics/Mods/Floors/Buck Converters Floor.stl
138.0 x 64.0 x 5.00
