BILLyTheLiTTle/RCCar_Engineering/Parts/Mechanics/Mods/Motor Cup Wedge.stl

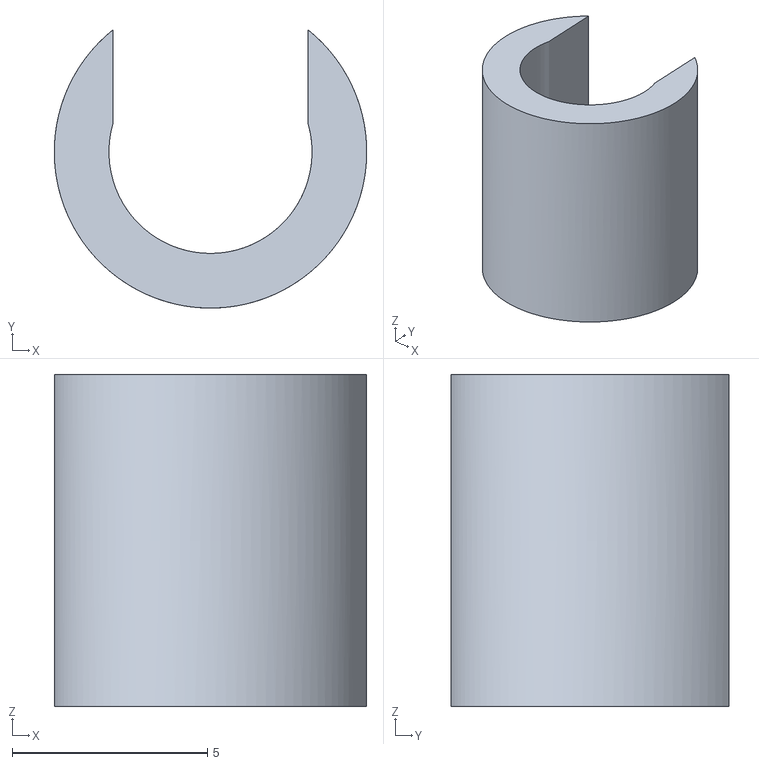
[picture p28: CAD file, 2019-07-31]
Parts/Mechanics/Mods/Motor Cup Wedge.stl
8.00 x 7.12 x 8.50
