BILLyTheLiTTle/RCCar_Engineering/Parts/Mechanics/Mods/Standoffs/10mm height.stl

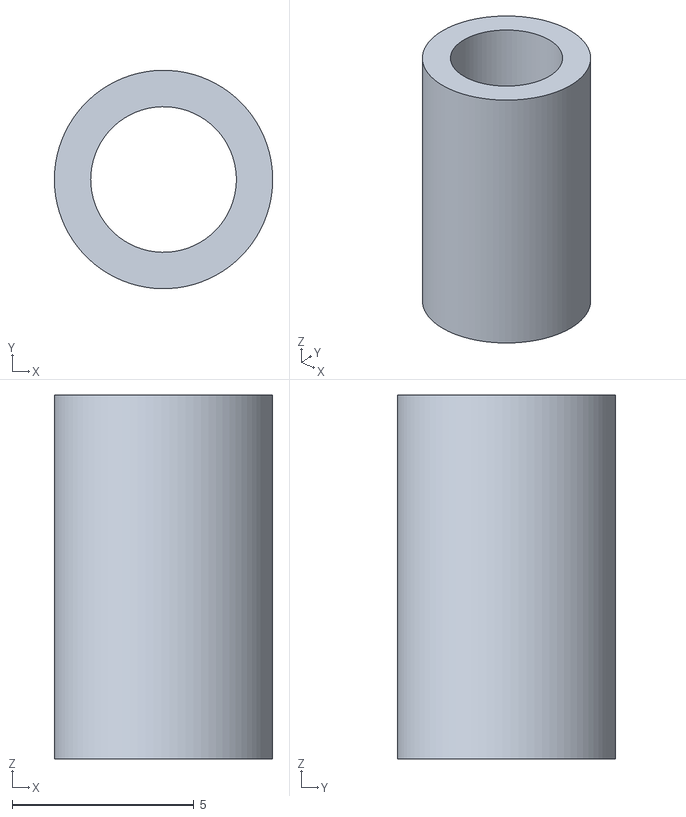
[picture p29: CAD file, 2019-10-11]
Parts/Mechanics/Mods/Standoffs/10mm height.stl
6.00 x 6.00 x 10.0
