BILLyTheLiTTle/RCCar_Engineering/Parts/Mechanics/Steering System/Servo housing.stl

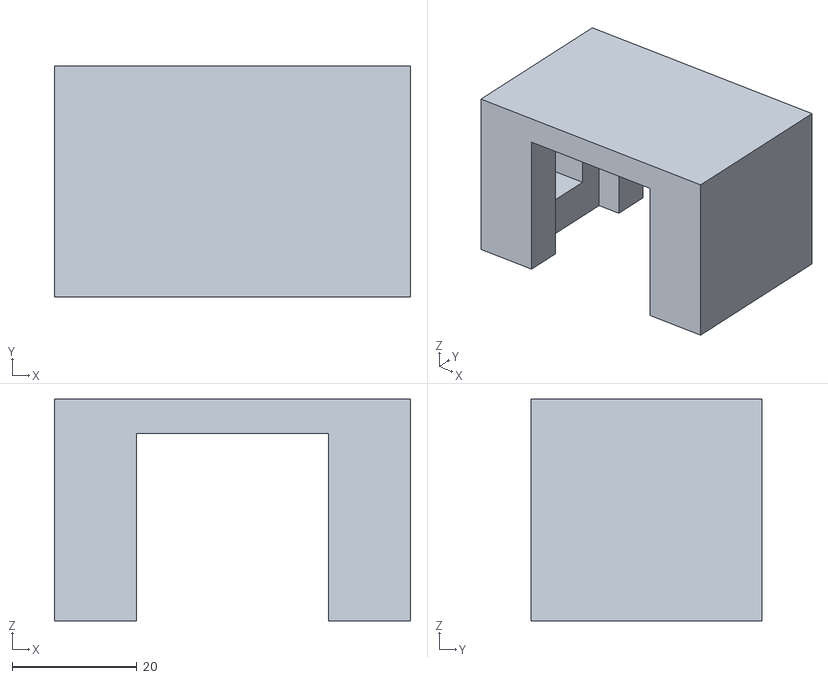
[picture p30: CAD file, 2019-10-03]
Parts/Mechanics/Steering System/Servo housing.stl
57.0 x 37.0 x 35.5
