BILLyTheLiTTle/RCCar_Engineering/Parts/Mechanics/Suspension System/Arm Chassis Connector.stl

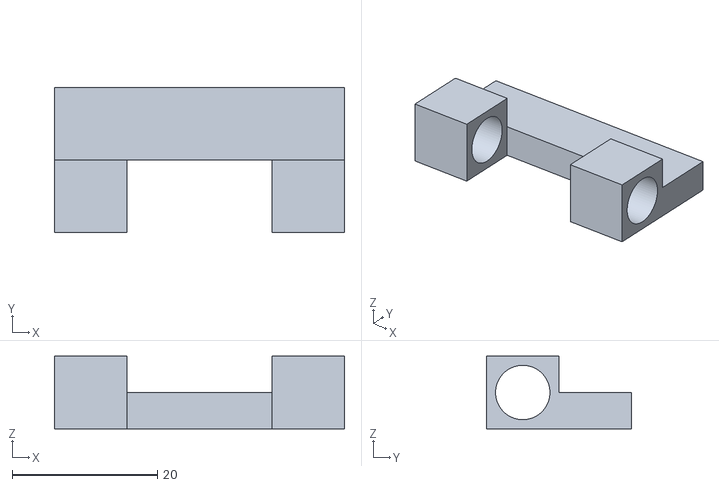
[picture p31: CAD file, 2019-08-02]
Parts/Mechanics/Suspension System/Arm Chassis Connector.stl
40.0 x 20.0 x 10.0
