BILLyTheLiTTle/RCCar_Engineering/Parts/Mechanics/Suspension System/Rear/Rear Arm Wheel Dowel Pin.stl

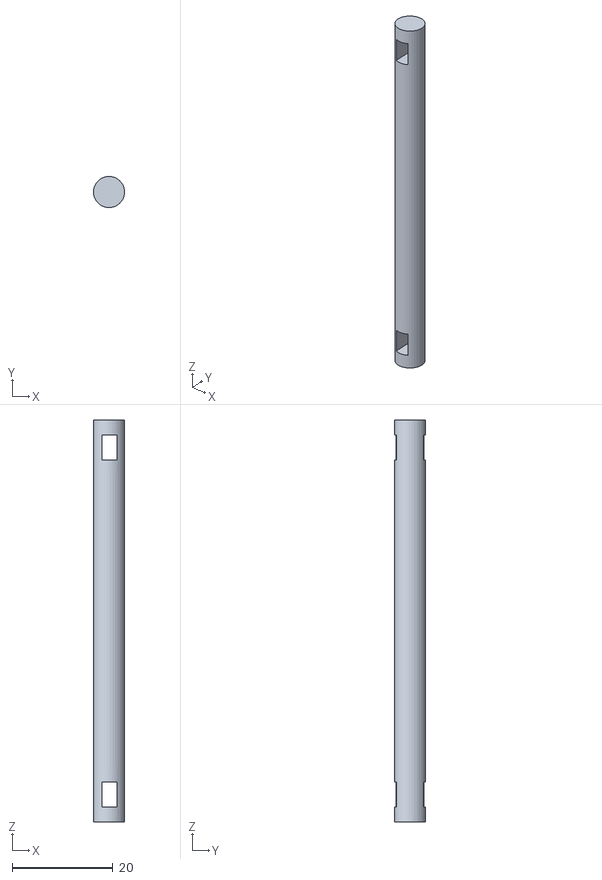
[picture p32: CAD file, 2019-08-29]
Parts/Mechanics/Suspension System/Rear/Rear Arm Wheel Dowel Pin.stl
6.19 x 6.20 x 80.0
