BILLyTheLiTTle/RCCar_Engineering/Parts/Mechanics/Transmission System/3rd party design/BTS7960 Housing.stl

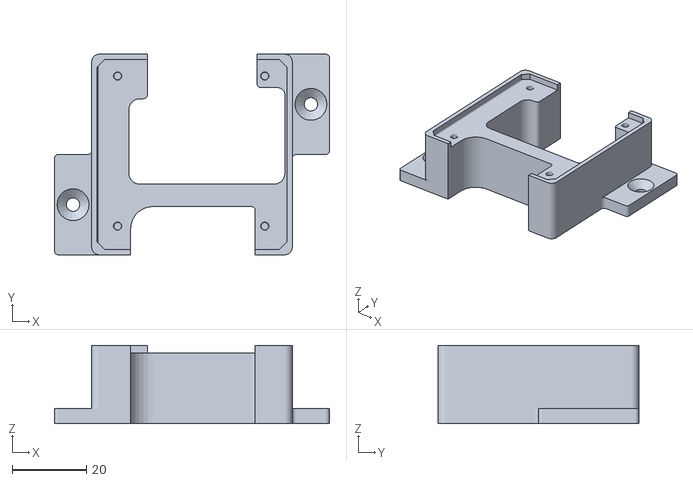
[picture p33: CAD file, 2020-02-27]
Parts/Mechanics/Transmission System/3rd party design/BTS7960 Housing.stl
74.0 x 54.0 x 21.0
