BILLyTheLiTTle/RCCar_Engineering/Parts/Mechanics/Wheels/Front/Inner Arm Polygon Wedge Print.stl

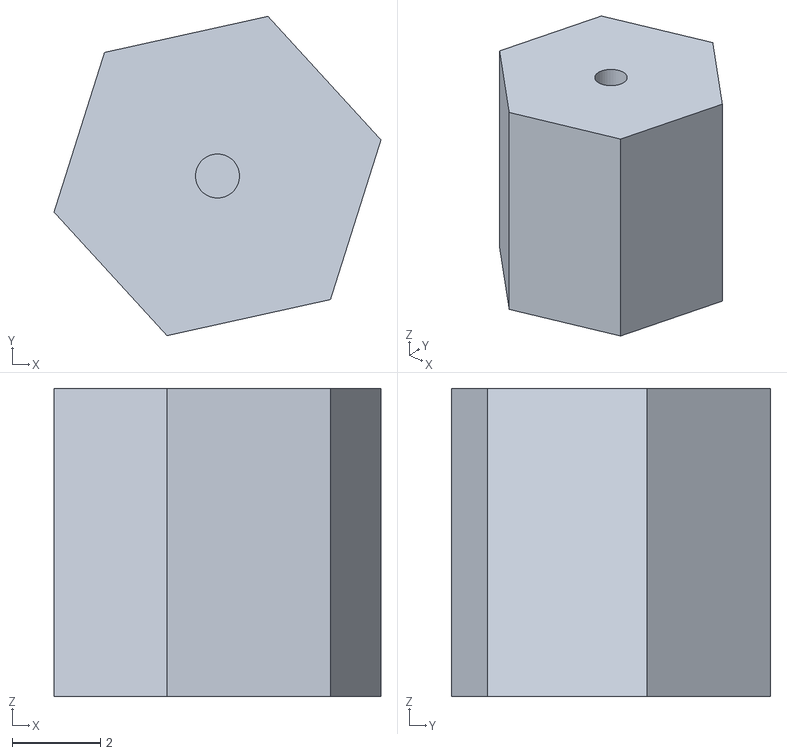
[picture p34: CAD file, 2019-10-01]
Parts/Mechanics/Wheels/Front/Inner Arm Polygon Wedge Print.stl
7.42 x 7.25 x 7.00
