BILLyTheLiTTle/RCCar_Engineering/Parts/Mechanics/Wheels/Rear/Rear Hub Adapter.stl

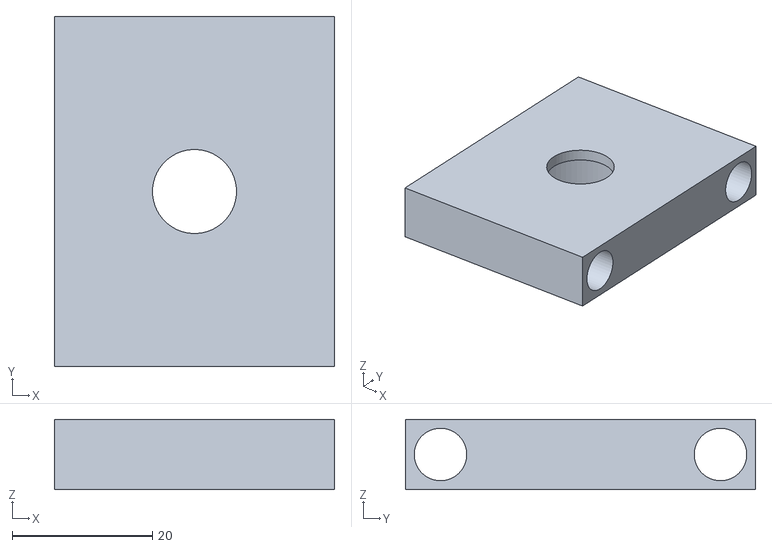
[picture p35: CAD file, 2019-08-27]
Parts/Mechanics/Wheels/Rear/Rear Hub Adapter.stl
40.0 x 50.0 x 10.0
