BILLyTheLiTTle/RCCar_Engineering/Mechanics/Steering System/Rack -n- Pinion Tests/Steering Polygon Wedge Print.stl

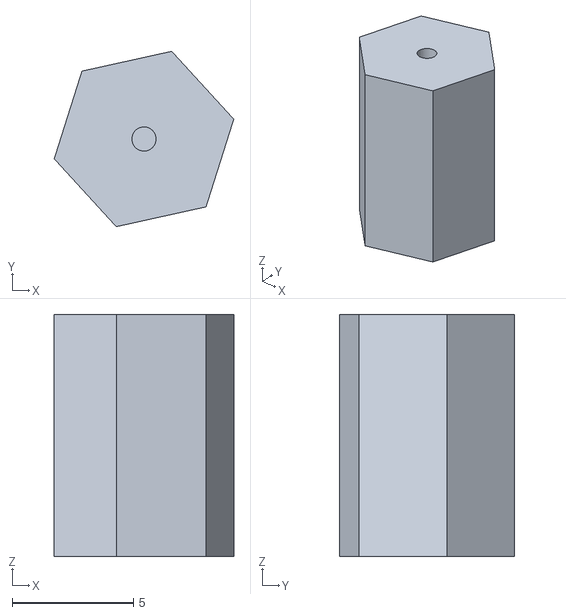
[picture p36: CAD file, 2019-10-01]
Mechanics/Steering System/Rack -n- Pinion Tests/Steering Polygon Wedge Print.stl
7.42 x 7.25 x 10.0
