BILLyTheLiTTle/RCCar_Engineering/Parts/Mechanics/Mods/Floors/Perfboard Power System Floor.stl

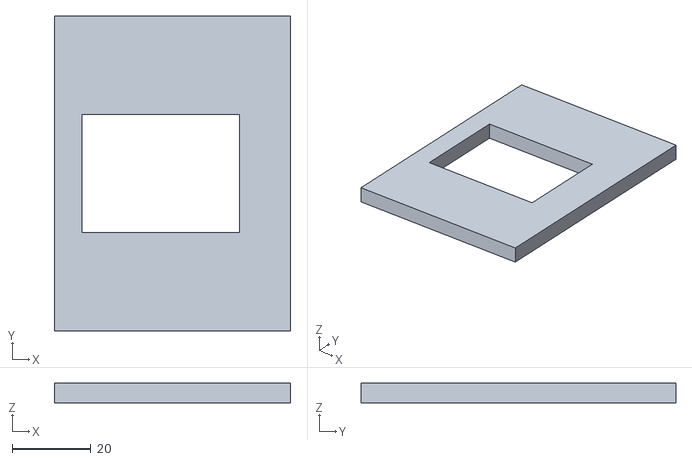
[picture p37: CAD file, 2019-12-05]
Parts/Mechanics/Mods/Floors/Perfboard Power System Floor.stl
60.0 x 80.0 x 5.00
