BILLyTheLiTTle/RCCar_Engineering/Parts/Mechanics/Steering System/Tie Rod.stl

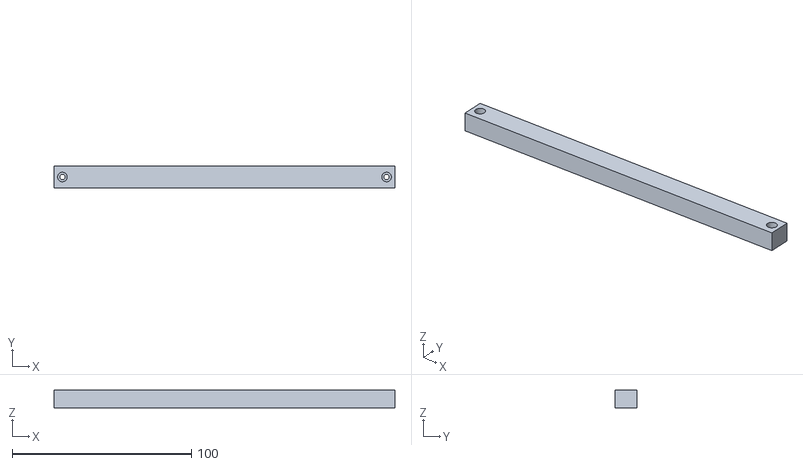
[picture p38: CAD file, 2019-09-27]
Parts/Mechanics/Steering System/Tie Rod.stl
190.0 x 12.0 x 10.0
