BILLyTheLiTTle/RCCar_Engineering/Parts/Mechanics/Suspension System/Rear/Rear Arms.stl

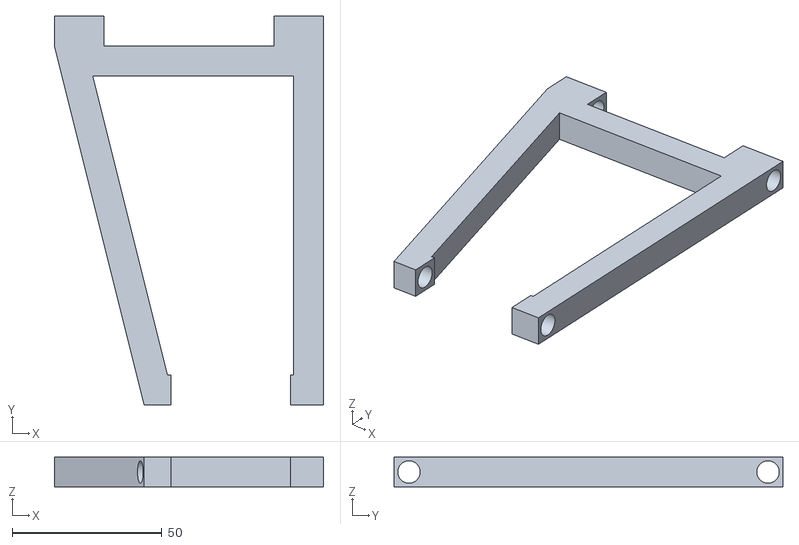
[picture p39: CAD file, 2019-08-02]
Parts/Mechanics/Suspension System/Rear/Rear Arms.stl
90.0 x 130.0 x 10.0
