BILLyTheLiTTle/RCCar_Engineering/Parts/Mechanics/Wheels/Front/Outer Arm Polygon Wedge Print.stl

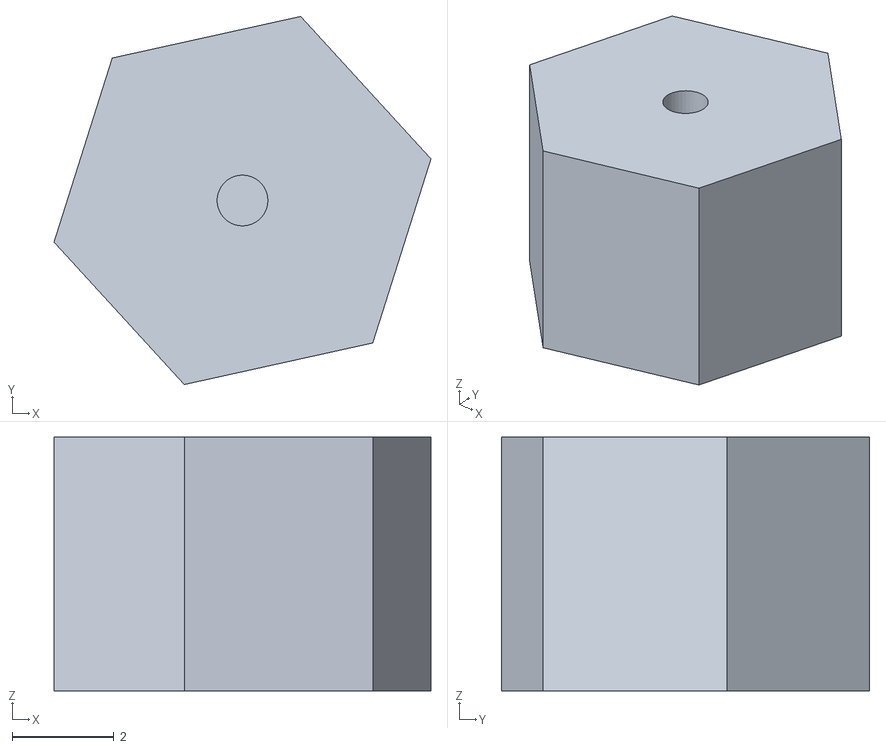
[picture p40: CAD file, 2019-10-01]
Parts/Mechanics/Wheels/Front/Outer Arm Polygon Wedge Print.stl
7.42 x 7.25 x 5.00
