BILLyTheLiTTle/RCCar_Engineering/Parts/Mechanics/Mods/Floors/Perfboard Servo System Floor.stl

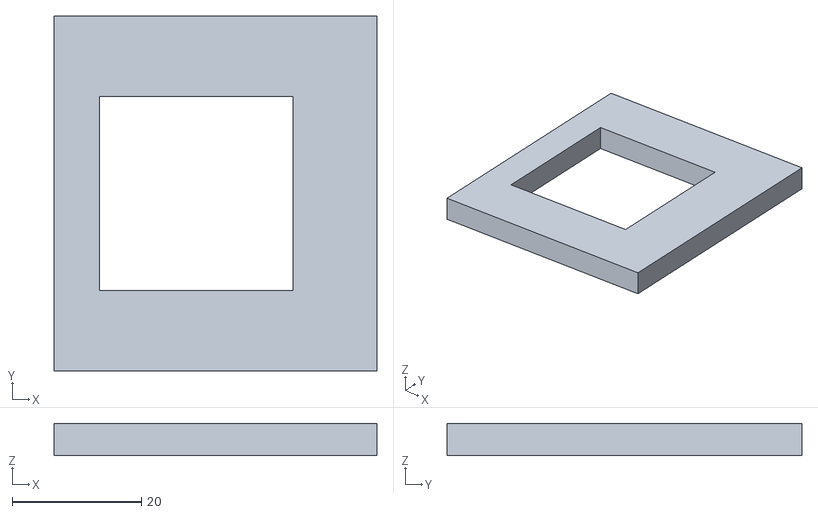
[picture p41: CAD file, 2019-12-05]
Parts/Mechanics/Mods/Floors/Perfboard Servo System Floor.stl
50.0 x 55.0 x 5.00
