BILLyTheLiTTle/RCCar_Engineering/Parts/Mechanics/Wheels/Wheel.stl

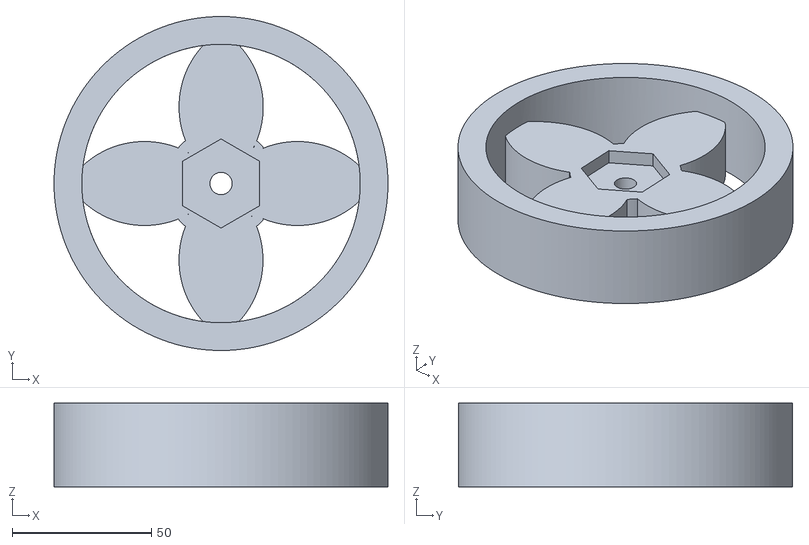
[picture p42: CAD file, 2019-07-30]
Parts/Mechanics/Wheels/Wheel.stl
120.0 x 120.0 x 30.0
