BILLyTheLiTTle/RCCar_Engineering/Mechanics/Steering System/Rack -n- Pinion Tests/Rack.stl

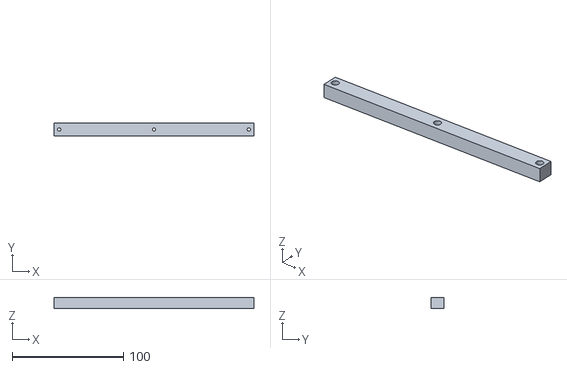
[picture p43: CAD file, 2019-09-25]
Mechanics/Steering System/Rack -n- Pinion Tests/Rack.stl
180.0 x 12.0 x 10.0
