BILLyTheLiTTle/RCCar_Engineering/Parts/Mechanics/Wheels/Front/Front Right Hub Adapter.stl

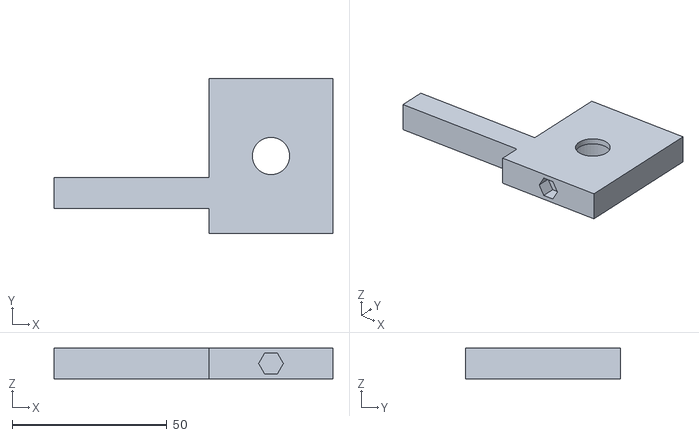
[picture p44: CAD file, 2019-09-27]
Parts/Mechanics/Wheels/Front/Front Right Hub Adapter.stl
90.0 x 50.0 x 10.0
