BILLyTheLiTTle/RCCar_Engineering/Mechanics/Steering System/Rack -n- Pinion Tests/Inner Tie Rod.stl

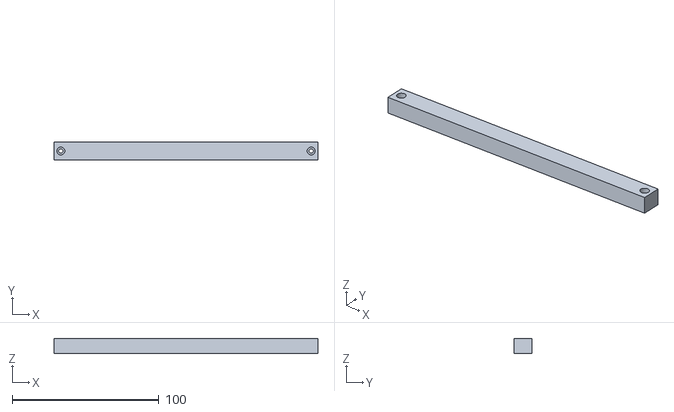
[picture p45: CAD file, 2019-09-25]
Mechanics/Steering System/Rack -n- Pinion Tests/Inner Tie Rod.stl
180.0 x 12.0 x 10.0
