BILLyTheLiTTle/RCCar_Engineering/(list of files, cad)

Other CAD files:
Parts/Mechanics/Wheels/Front/Tests/Polygon Side Print.stl
Parts/Mechanics/Wheels/Rear/Rear Dogbone.stl
Mechanics/Steering System/Rack -n- Pinion Tests/Right Rack n Rod Connector.stl
Parts/Mechanics/Wheels/Front/Front Left Dogbone.stl
Parts/Mechanics/Wheels/Front/Front Left Hub Adapter.stl
Parts/Mechanics/Steering System/Rack -n- Pinion/Original/Zahnstange_und_ritzel.scad
Mechanics/Steering System/Rack -n- Pinion Tests/Inner Tie Rod.f3d
Mechanics/Steering System/Rack -n- Pinion Tests/Left Rack n Rod Connector.f3d
Mechanics/Steering System/Rack -n- Pinion Tests/Rack.f3d
Mechanics/Steering System/Rack -n- Pinion Tests/Right Rack n Rod Connector.f3d
Mechanics/Steering System/Rack -n- Pinion Tests/Secondary Pinion.f3d
Mechanics/Steering System/Rack -n- Pinion Tests/Steering Polygon Wedge Print.f3d
Parts/Mechanics/Mods/Floors/Buck Converters Floor.f3d
Parts/Mechanics/Mods/Floors/Perfboard Power System Floor.f3d
Parts/Mechanics/Mods/Floors/Perfboard Rpi Expander Floor.f3d
Parts/Mechanics/Mods/Floors/Perfboard Servo System Floor.f3d
Parts/Mechanics/Mods/Motor Cup Stop.f3d
Parts/Mechanics/Mods/Motor Cup Wedge.f3d
Parts/Mechanics/Mods/Standoffs/10mm height.f3d
Parts/Mechanics/Mods/Standoffs/5mm height.f3d
Parts/Mechanics/Steering System/Deprecated Rack -n- Pinion/Inner Tie Rod.f3d
Parts/Mechanics/Steering System/Deprecated Rack -n- Pinion/Left Rack n Rod Connector.f3d
Parts/Mechanics/Steering System/Deprecated Rack -n- Pinion/Rack.f3d
Parts/Mechanics/Steering System/Deprecated Rack -n- Pinion/Right Rack n Rod Connector.f3d
Parts/Mechanics/Steering System/Deprecated Rack -n- Pinion/Right Rack n Rod Connector.stl
Parts/Mechanics/Steering System/Deprecated Rack -n- Pinion/Secondary Pinion.f3d
Parts/Mechanics/Steering System/Deprecated Rack -n- Pinion/Steering Polygon Wedge Print.f3d
Parts/Mechanics/Steering System/Rack Wedge.f3d
Parts/Mechanics/Steering System/Servo housing.f3d
Parts/Mechanics/Steering System/Tests/Half Tie Rod Type A.f3d
Parts/Mechanics/Steering System/Tests/Outer Tie Rod.f3d
Parts/Mechanics/Steering System/Tie Rod.f3d
Parts/Mechanics/Suspension System/Arm Chassis Connector.f3d
Parts/Mechanics/Suspension System/Arm Chassis Dowel Pin.f3d
Parts/Mechanics/Suspension System/Front/Front Arms.f3d
Parts/Mechanics/Suspension System/Front/Tests/Bearing Arm hole.f3d
Parts/Mechanics/Suspension System/Rear/Rear Arm Wheel Dowel Pin.f3d
Parts/Mechanics/Suspension System/Rear/Rear Arm Wheel Dowel Stop.f3d
Parts/Mechanics/Suspension System/Rear/Rear Arms.f3d
Parts/Mechanics/Transmission System/3rd party design/BTS7960 Housing Stands.f3d
Parts/Mechanics/Transmission System/BTS7960 Housing.f3d
Parts/Mechanics/Wheels/Front/Front Left Dogbone.f3d
Parts/Mechanics/Wheels/Front/Front Left Hub Adapter.f3d
Parts/Mechanics/Wheels/Front/Front Right Dogbone.f3d
Parts/Mechanics/Wheels/Front/Front Right Hub Adapter.f3d
Parts/Mechanics/Wheels/Front/Inner Arm Polygon Wedge Print.f3d
Parts/Mechanics/Wheels/Front/Outer Arm Polygon Wedge Print.f3d
Parts/Mechanics/Wheels/Front/Tests/Hub Adapter.f3d
Parts/Mechanics/Wheels/Front/Tests/Polygon Side Print.f3d
Parts/Mechanics/Wheels/Rear/Rear Dogbone.f3d
Parts/Mechanics/Wheels/Rear/Rear Hub Adapter.f3d
Parts/Mechanics/Wheels/Tests/Wheel Cup.f3d
Parts/Mechanics/Wheels/Wheel Cup.f3d
Parts/Mechanics/Wheels/Wheel hub nut dowel pin.f3d
Parts/Mechanics/Wheels/Wheel hub nut dowel pin.stl
Parts/Mechanics/Wheels/Wheel hub nut.f3d
Parts/Mechanics/Wheels/Wheel hub nut.stl
Parts/Mechanics/Wheels/Wheel.f3d
Tools/Veroboard Drill Handler.f3d
