BILLyTheLiTTle/RCCar_Engineering/Parts/Mechanics/TODO/Double Cardan.png

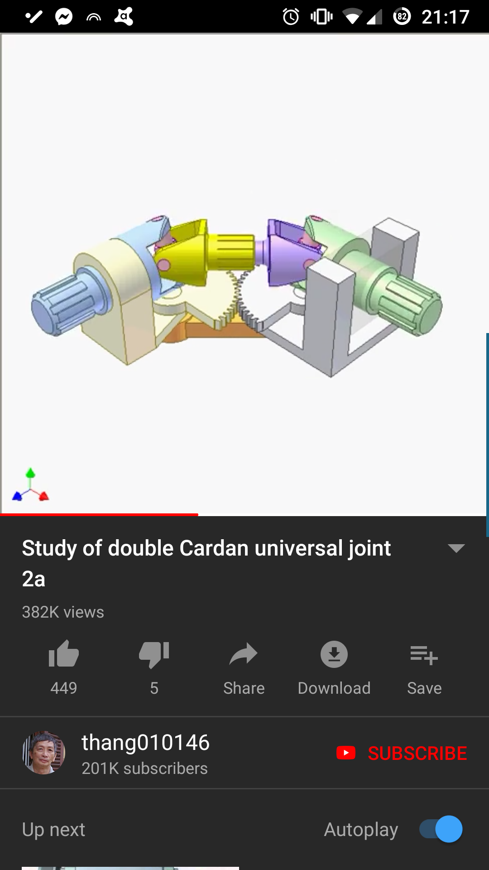
Parts/Mechanics/TODO/Double Cardan.png
