BILLyTheLiTTle/RCCar_Engineering/(list of files, drawings)

Other design files:
Designs/Electronics/1. Power System/Buck Converters.fzz
Designs/Electronics/1. Power System/Deprecated/Regulator 5V.fzz
Designs/Electronics/2. Steering System/Breadboard/Servo Controller.fzz
Designs/Electronics/2. Steering System/Perfboard/Servo Controller.fzz
Designs/Electronics/3. Transmission System/Breadboard/BTS7960 Connection System.fzz
Designs/Electronics/3. Transmission System/Perfboard/BTS7960 Connection System.fzz
Designs/Electronics/4. Cooling System/Breadboard/Water Cooling Conection System.fzz
Designs/Electronics/4. Cooling System/Perfboard/Water Cooling Conection System.fzz
