BILLyTheLiTTle/RCCar_Engineering/(commit log)

2019-07-15 Add 3D printing designs
    [Arm Dowel Pin.f3d, Back Arms.f3d, Hub Adapter.f3d, Wheel hub nut dowel pin.f3d, Wheel hub nut.f3d, Wheel.f3d]
2019-07-18 Wedge for motor connecting cup
    [Motor Cup Wedge.f3d]
2019-07-30 Create STL files
    [Arm Dowel Pin.stl, Back Arms.stl, Hub Adapter.stl, Motor Cup Wedge.stl, Wheel hub nut dowel pin.stl, Wheel hub nut.stl, Wheel.stl]
2019-07-31 Fix motor cup wedge
    [Motor Cup Wedge.f3d, Motor Cup Wedge.stl]
2019-07-31 Modify arms implementation
    [Arm Chassis Connector.f3d, Arm Dowel Pin.f3d, Arm Dowel Pin.stl, Back Arms.f3d, Back Arms.stl]
2019-08-02 Create STL files for suspension
    [Arm Chassis Connector.stl, Arm Dowel Pin.stl, Back Arms.stl]
2019-08-02 Fix arm dowel pin
    [Arm Dowel Pin.f3d, Arm Dowel Pin.stl]
2019-08-02 Fix arm chassis points
    [Back Arms.f3d, Back Arms.stl]
2019-08-08 Modify wheel hub nut
    [Wheel hub nut.f3d, Wheel hub nut.stl]
2019-08-08 Modify Wheel hub nut dowel pin
    [Wheel hub nut dowel pin.f3d, Wheel hub nut dowel pin.stl]
2019-08-27 Improve hub adapter
    [Hub Adapter.f3d, Hub Adapter.stl]
2019-08-27 Design wheel cup
    [Wheel Cup.f3d, Wheel Cup.stl]
2019-08-28 Improve wheel cup
    [Wheel Cup.f3d, Wheel Cup.stl]
2019-08-28 Design dogbone
    [Dogbone.f3d, Dogbone.stl]
2019-08-28 Improve dogbone
    [Dogbone.f3d, Dogbone.stl]
2019-08-29 Improve arm wheel dowel connection
    [Arm Chassis Dowel Pin.f3d, Arm Chassis Dowel Pin.stl, Arm Wheel Dowel Pin.f3d, Arm Wheel Dowel Pin.stl, Arm Wheel Dowel Stop.f3d, Arm Wheel Dowel Stop.stl, Motor Cup Stop.f3d, Motor Cup Stop.stl]
2019-08-29 Improve arm wheel dowel stop
    [Arm Wheel Dowel Stop.f3d, Arm Wheel Dowel Stop.stl]
2019-08-29 Improve motor cup stop
    [Motor Cup Stop.f3d, Motor Cup Stop.stl]
2019-08-29 Better organization
    [Arm Chassis Connector.f3d, Arm Chassis Connector.stl, Arm Chassis Dowel Pin.f3d, Arm Chassis Dowel Pin.stl, Arm Wheel Dowel Pin.f3d, Arm Wheel Dowel Pin.stl, Arm Wheel Dowel Stop.f3d, Arm Wheel Dowel Stop.stl]
2019-09-02 Design front arms
    [Arms.f3d, Arms.stl]
2019-09-03 Polygon Print Test Scheme
    [Hub Adapter.f3d, Polygon Side Print v0.f3d, Polygon Side Print v1.stl]
2019-09-03 Polygon Wedge Test Print
    [Polygon Wedge Print v1.f3d, Polygon Wedge Print v1.stl]
2019-09-03 Front Hub Adapter Design
    [Hub Adapter.f3d, Hub Adapter.stl, Polygon Side Print.f3d, Polygon Side Print.stl, Polygon Wedge Print.f3d, Polygon Wedge Print.stl]
2019-09-04 Improve Rear Dog Bone
    [Dogbone.f3d, Dogbone.stl]
2019-09-04 Improve Front Hub Adapter
    [Hub Adapter.f3d, Hub Adapter.stl]
2019-09-04 Design Rack and Tie Rods
    [Arms.f3d, Half Tie Rod Type A.f3d, Inner Tie Rod.f3d, Outer Tie Rod.f3d, Rack.f3d]
2019-09-06 Design Rack N Rod Connector
    [Bearing Arm hole.f3d, Rack n Rod Connector.f3d]
2019-09-06 Design Secondary Pinion
    [Secondary Pinion.f3d]
2019-09-19 Improve small bearing hole
    [Arms.f3d]
2019-09-23 Improve test parts for front suspension system
    [Bearing Arm hole.f3d, Bearing Arm hole.stl, Polygon Wedge Print.f3d, Polygon Wedge Print.stl]
2019-09-23 Improve parts for front suspension system
    [Arms.f3d, Arms.stl, Polygon Wedge Print.f3d, Polygon Wedge Print.stl]
2019-09-25 Minor improvements for bearing
    [Inner Tie Rod.f3d, Inner Tie Rod.stl, Outer Tie Rod.f3d, Outer Tie Rod.stl, Rack n Rod Connector.f3d, Rack n Rod Connector.stl, Rack.f3d, Rack.stl]
2019-09-26 Improve outer tie rod
    [Outer Tie Rod.f3d, Outer Tie Rod.stl]
2019-09-27 Improve designs for front car parts
    [Front Arms.f3d, Front Arms.stl, Front Left Hub Adapter.f3d, Front Left Hub Adapter.stl, Front Right Hub Adapter.f3d, Front Right Hub Adapter.stl, Half Tie Rod Type A.f3d, Hub Adapter.f3d]
2019-09-30 Change parameters for wheel cup
    [Wheel Cup.f3d, Wheel Cup.stl]
2019-09-30 Wheel cup as a test
    [Wheel Cup.f3d, Wheel Cup.stl]
2019-09-30 Wheel cup as a test for hub nut
    [Wheel Cup.f3d, Wheel Cup.stl]
2019-10-01 Improve parameters for wheel cup
    [Wheel Cup.f3d, Wheel Cup.stl]
2019-10-01 Improve parameters for secondary pinion
    [Secondary Pinion.f3d, Secondary Pinion.stl]
2019-10-01 Improve parameters for front dogbone
    [Front Dogbone.f3d, Front Dogbone.stl, Rear Dogbone.f3d, Rear Dogbone.stl]
2019-10-01 Improve parameters for polygon wedges
    [Inner Arm Polygon Wedge Print.f3d, Inner Arm Polygon Wedge Print.stl, Outer Arm Polygon Wedge Print.f3d, Outer Arm Polygon Wedge Print.stl, Polygon Wedge Print.f3d, Polygon Wedge Print.stl, Steering Polygon Wedge Print.f3d, Steering Polygon Wedge Print.stl]
2019-10-01 Fix rack -n- rod connector part
    [Left Rack n Rod Connector.f3d, Left Rack n Rod Connector.stl, Right Rack n Rod Connector.f3d, Right Rack n Rod Connector.stl]
2019-10-02 Use another design for front right dogbone
    [Front Left Dogbone.f3d, Front Left Dogbone.stl, Front Right Dogbone.f3d, Front Right Dogbone.stl]
2019-10-02 Improve secondary pinion
    [Secondary Pinion.f3d, Secondary Pinion.stl]
2019-10-02 Improve rack -n- pinion implementation
    [Inner Tie Rod.f3d, Inner Tie Rod.stl, Left Rack n Rod Connector.f3d, Left Rack n Rod Connector.stl, Rack.f3d, Rack.stl, Right Rack n Rod Connector.f3d, Right Rack n Rod Connector.stl]
2019-10-03 Design servo housing
    [Servo housing.f3d, Servo housing.stl]
2019-10-04 Design rack wedge
    [Rack Wedge.f3d, Rack Wedge.stl]
2019-10-07 Start the electronics' designs
    [GPIOs data.xlsx]
2019-10-08 Deprecate designs
    [Inner Tie Rod.f3d, Inner Tie Rod.stl, Left Rack n Rod Connector.f3d, Left Rack n Rod Connector.stl, Rack.f3d, Rack.stl, Regulator 5V.fzz, Right Rack n Rod Connector.f3d]
2019-10-09 Design power system circuit with converters
    [Buck Converters.fzz, GPIOs data.xlsx, Servo Controller.fzz]
2019-10-10 Design Servo backup power system
    [Buck Converters.fzz, Servo Backup Circuit.fzz, Servo Controller.fzz]
2019-10-11 Design PowerRack standoff
    [Rpi PowerRack Standoff.f3d, Rpi PowerRack Standoff.stl]
2019-10-15 Minor improvements
    [Buck Converters.fzz, Servo Backup Circuit.fzz, Servo Controller.fzz]
2019-10-16 Write down the pins connections for motors
    [BTS7960 Connection System.fzz, GPIOs data.xlsx]
2019-10-17 Design circuits for logic commands
    [BTS7960 Connection System.fzz]
2019-10-18 Design circuits for bts7960 bridges
    [BTS7960 Connection System.fzz]
2019-10-18 Minor improvements for PCB size
    [Servo Backup Circuit.fzz]
2019-10-21 Minor changes
    [Buck Converters.fzz]
2019-10-21 Design circuits for water cooling
    [BTS7960 Connection System.fzz, GPIOs data.xlsx, Water Cooling Conection System.fzz]
2019-10-21 Improve cable management
    [BTS7960 Connection System.fzz, Buck Converters.fzz, Regulator 5V.fzz, Servo Backup Circuit.fzz, Servo Controller.fzz, Water Cooling Conection System.fzz]
2019-11-12 Floor and Standoffs for Buck Converters
    [Buck Converter Standoff.f3d, Buck Converter Standoff.stl, Buck Converters Floor.f3d, Buck Converters Floor.stl, Rpi PowerRack Standoff.f3d, Rpi PowerRack Standoff.stl]
2019-11-28 Export electronic circuits as images for faster viewing
2019-12-05 More Floors
    [10mm height.f3d, 10mm height.stl, 5mm height.f3d, 5mm height.stl, Buck Converters Floor.f3d, Buck Converters Floor.stl, Perfboard Power System Floor.f3d, Perfboard Power System Floor.stl]
2019-12-07 Change pin for steering
    [GPIOs data.xlsx]
2019-12-07 Improve electronics data stats
    [GPIOs data.xlsx]
2019-12-09 Rpi Expander Floor
    [Perfboard Rpi Expander Floor.f3d, Perfboard Rpi Expander Floor.stl, Veroboard Drill Handler.f3d, Veroboard Drill Handler.stl]
2019-12-18 Improve transmission system design
    [BTS7960 Connection System.fzz]
2019-12-20 BTS7960 Housing
    [BTS7960 housing.f3d, BTS7960 housing.stl]
2020-01-09 Redesign using breadboards
    [BTS7960 Connection System.fzz, GPIOs data.xlsx, Servo Controller.fzz, Water Cooling Conection System.fzz]
2020-01-28 Software Differential functionality description
    [10mm height.f3d, 10mm height.stl, 5mm height.f3d, 5mm height.stl, Arm Chassis Connector.f3d, Arm Chassis Connector.stl, Arm Chassis Dowel Pin.f3d, Arm Chassis Dowel Pin.stl]
2020-02-24 Show breadbord designs
    [BTS7960 Connection System.fzz, Servo Controller.fzz, Water Cooling Conection System.fzz]
2020-02-27 BTS7960 mount
    [BTS7960Mount.stl]
2020-02-27 BTS7960 housing stands
    [BTS7960 Housing Stands.f3d, BTS7960 Housing Stands.stl, BTS7960 Housing.stl]
2020-03-04 BTS7960 My Housing
    [BTS7960 Housing Stands.f3d, BTS7960 Housing Stands.stl, BTS7960 Housing.f3d, BTS7960 Housing.stl]
2020-03-09 Change cable color according to my real cables
    [BTS7960 Connection System.fzz]
2020-03-21 Change values for pull down resistors
    [BTS7960 Connection System.fzz]
2020-05-04 Comments for motor wiring
    [BTS7960 Connection System.fzz]
2020-08-02 Fix RESET pin connection for MCP23S17
    [BTS7960 Connection System.fzz]
2020-08-13 Minor fixes
    [GPIOs data.xlsx]
